avj17/Audio_amplifier_design/Final_report.pdf

# Electronic Workshop 2: Audio Amplifier Design Report

HEMANTH G and ARUN VENKAT JONNA IIIT Hyderabad

March 5, 2026

## 1 Introduction

This report details the design and simulation of a multi-stage amplifier circuit. The system is designed to process an audio signal through four distinct stages: a Pre-amplifier, a Gain Stage, a Band Pass Filter (BPF), and a final Class AB Power Amplifier stage to drive a load.

## 2 Pre-Amplifier

### 2.1 Circuit Topology

The pre-amplifier stage is implemented using a BJT Differential Amplifier. This configuration was selected because it provides:

- Moderate and controllable voltage gain
- High input impedance
- Inherent common-mode noise rejection
- Improved bias stability compared to single-ended CE stages

The circuit consists of two matched NPN transistors sharing a common emitter resistance (RE) connected to the negative supply rail. Equal collector resistors (RC ) are used, and the output is taken single-ended from one collector.

### 2.2 Large-Signal (DC Bias) Analysis

For DC analysis, all capacitors are treated as open-circuits.
The tail current is determined by the emitter resistor:

IE =

|VEE|
RE

(1)

With VEE = −5V and choosing:

IE = 3 mA | (2)

RE =

5
3
= 1.67 kΩ | (3)

The nearest standard value selected:

RE = 1.5 kΩ | (4)

Since the current splits equally:

IC =

IE
2
= 1.5 mA | (5)

The collector DC voltage becomes:

VC = VCC − IC RC | (6)

The Q-point is selected near the midpoint of the load line to allow maximum undistorted swing.

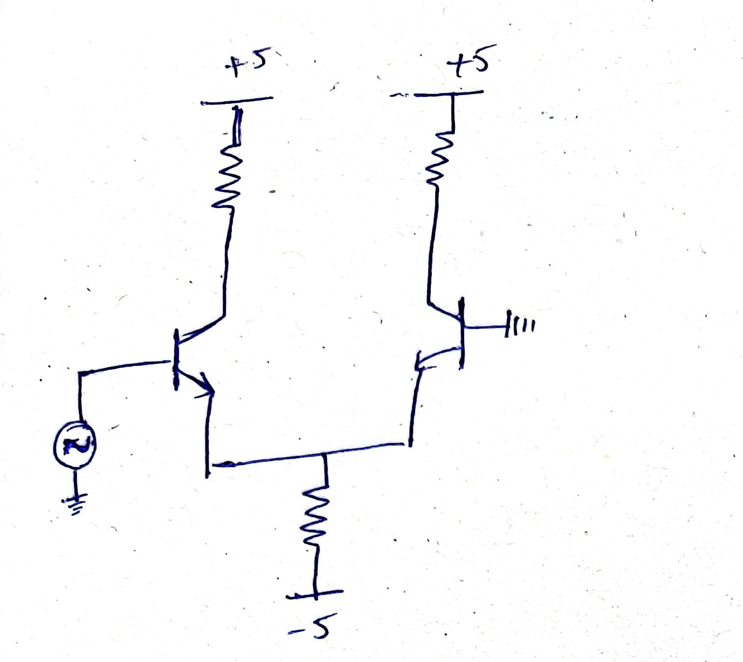
[picture p1: figure]

Figure 1: Large-Signal (DC Bias) equivalent circuit of the Differential Amplifier.

### 2.3 Small-Signal Gain Derivation

For small-signal analysis:

- DC sources are grounded.
- The hybrid-π model is used.

Let the differential input be:

v1 = −v2 | (7)

The emitter node voltage is denoted as ve.

Step 1: KCL at the Emitter Node

Applying KCL at the emitter node:

vπ1
rπ

+

vπ2
rπ

+ gmvπ1 + gmvπ2 =

ve
RE

(8)

Since:

vπ1 = v1 − ve | (9)
vπ2 = v2 − ve | (10)

For differential input:

v2 = −v1 | (11)

Thus:

vπ1 + vπ2 = (v1 − ve) + (−v1 − ve) = −2ve (12)

Substituting:
1
rπ

+ gm

(−2ve) = ve
RE

(13)

ve

2
gm +

1
rπ
+

1
RE
= 0 | (14)

For sufficiently large RE:

2

gm +

1
rπ
≫

1
RE

(15)

Hence,

ve ≈ 0 | (16)

Thus each transistor sees half of the differential input:

vπ1 =

vid
2

(17)

Step 2: Output Voltage

Collector current variation:

ic = gmvπ | (18)

Output voltage:

vo = −icRC | (19)

Substituting:

vo = −gmRC

vid
2

(20)

Therefore the differential voltage gain is:

Av =

vo

vid

= −

gmRC
2

(21)

The factor 1
2

arises because the differential input splits equally across the two transistors.

### 2.4 Transconductance Calculation

gm =

IC
VT

(22)

At room temperature:

VT ≈ 26 mV | (23)

For:

IC = 1.5 mA | (24)

gm =

1.5
26
= 0.0577 S | (25)

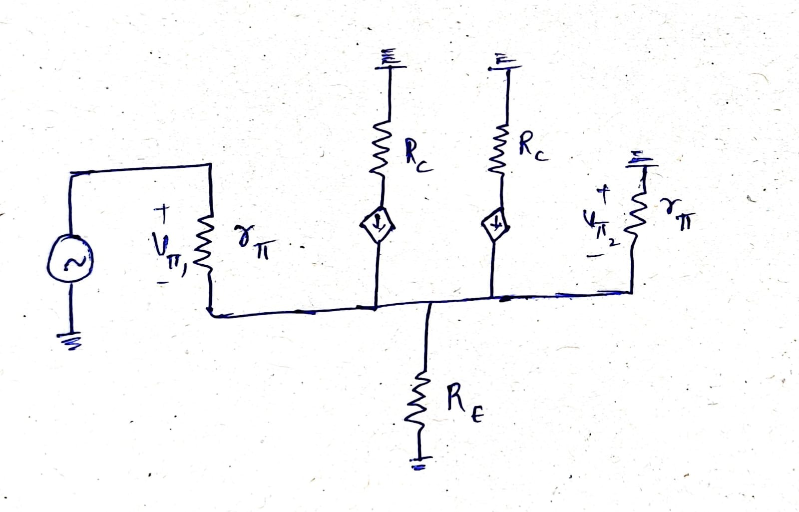
[picture p2: figure]

Figure 2: Small-Signal equivalent circuit of the Differential Amplifier.

### 2.5 Gain Requirement

Target gain:

Av = 16 | (26)

Using:

gmRC
2
= 16 | (27)
gmRC = 32 | (28)

RC =

32
0.0577
≈ 554.66 Ω | (29)

Selected standard value:

RC = 620 Ω | (30)

### 2.6 Input and Output Impedance

Input Impedance (Zin)

To determine the input impedance, we apply a test voltage source vx to the input terminal (the base of the transistor) and calculate the resulting test current ix drawn from the source. All independent AC sources are turned off.

The test current entering the base is simply the base current:
ix = ib | (31)

Applying Kirchhoff’s Voltage Law (KVL) from the base, through the emitter, to ground:

vx = ibrπ + ieRE | (32)

We know that the emitter current ie is the sum of the base and collector currents:

ie = ib + βib = (β + 1)ib | (33)

Substituting ie back into the KVL equation:

vx = ibrπ + (β + 1)ibRE | (34)

Factoring out ib (which is our test current ix):

vx = ix [rπ + (β + 1)RE] | (35)

The input impedance is the ratio of the test voltage to the test current:

Zin =

vx
ix
= rπ + (β + 1)RE | (36)

where rπ =

β
gm

. This demonstrates the impedance reflection rule, where the emitter resistance appears multiplied by (β + 1) when viewed from the base.

Output Impedance (Zout)

To find the output impedance, we turn off the input signal source (setting vin = 0) and apply a test voltage vx at the output node (the collector). We then measure the current ix entering the node.
With the input grounded (vin = 0), there is no excitation at the base, meaning:
ib = 0 and vπ = 0 | (37)

Because vπ = 0, the dependent current source of the BJT (gmvπ or βib) is zero, effectively acting as an open circuit.
Therefore, the only path for the test current ix to flow to AC ground is through the collector resistor RC . Applying Ohm’s law at the output node:
vx = ixRC | (38)

The output impedance is thus simply the ratio of the test voltage to the test current:

Zout =

vx
ix
= RC | (39)

### 2.7 Common Mode Rejection Ratio

(CMRR)

Differential gain:

Ad = 16.5 | (40)

Common-mode gain:

Acm = 2.02 × 10⁻²
(41)

CMRR =

Ad

Acm

(42)

CMRRdB = 20 log10
16.5
2.02 × 10⁻²
≈ 39.27 dB

(43)

### 2.8 Simulation Validation

To verify the theoretical calculations, the differential amplifier stage was simulated using LTspice. A transient analysis was performed to measure the large-signal biasing and small-signal voltage gain, while an AC sweep was used to confirm the frequency response and Common Mode Rejection Ratio (CMRR).

Voltage Gain Verification

A differential sinusoidal input signal was applied to the bases of the two transistors.
- Input Signal: vin = 10 mVpk at 1 kHz.
- Measured Output: The transient analysis shows an amplified output signal at the collector.
- Result: The simulated peak-to-peak output voltage divided by the input voltage yields a simulated gain that closely matches our theoretical design target of Av = 16.

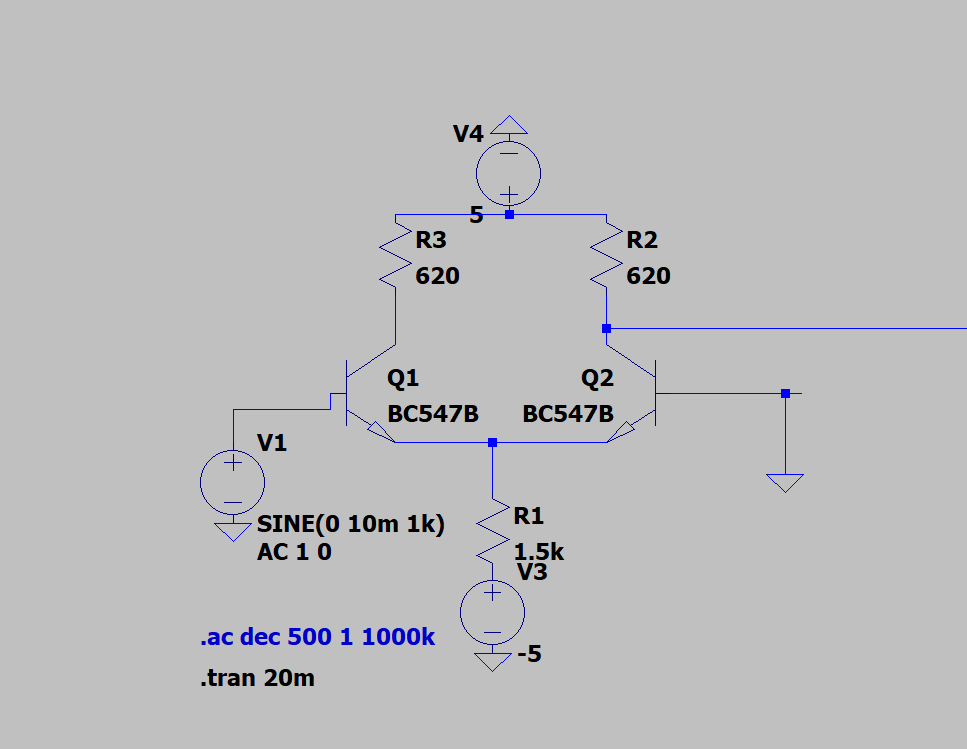
[picture p3: figure]

Figure 3: LTspice Schematic of the Differential Pre-Amplifier Stage.

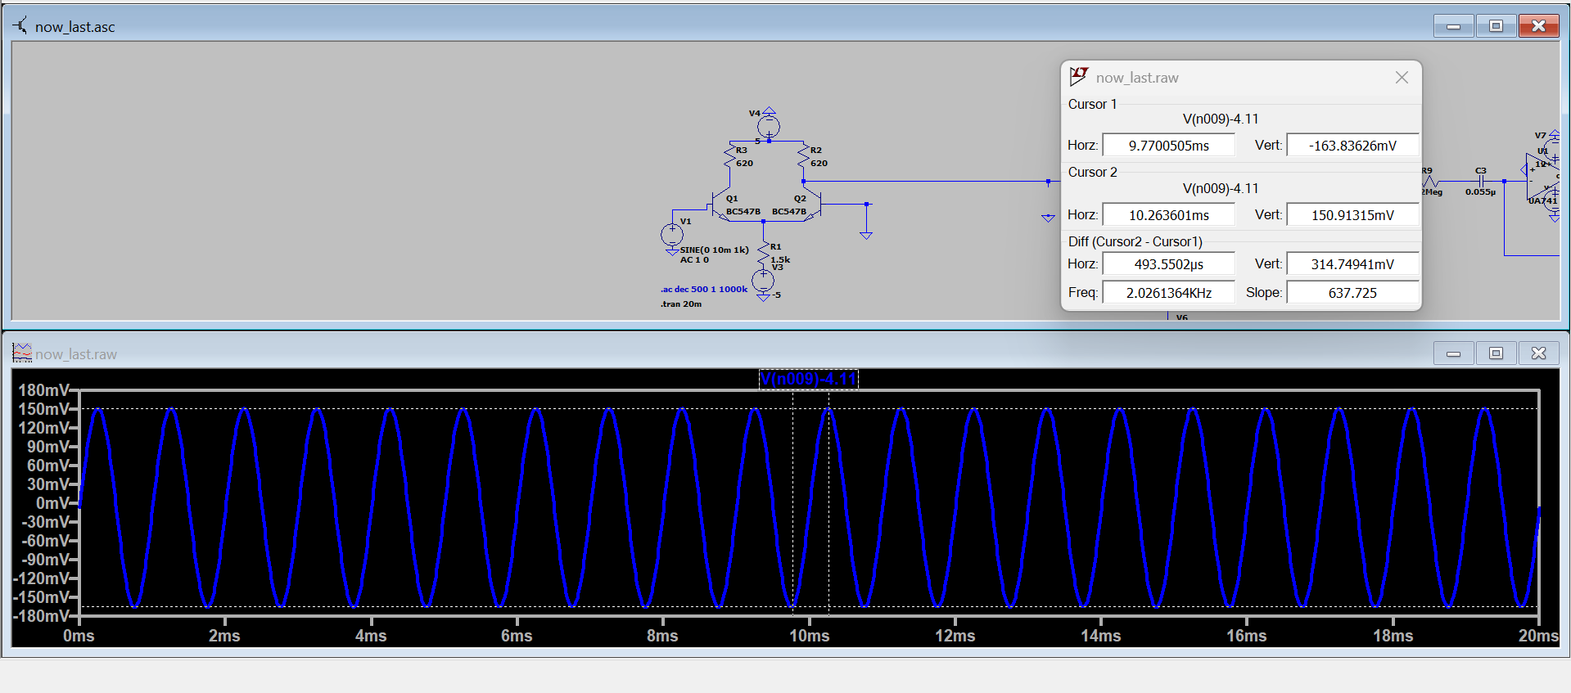
[picture p4: figure]

Figure 4: Transient Analysis: Input vs. Output waveforms confirming a voltage gain of approximately 16.

### 2.9 Design Rationale: Gain Limitation

The target differential voltage gain for the pre-amplifier was intentionally constrained to a moderate value (Av = 16, which is strictly < 20) rather than maximizing it. This design choice is grounded in several fundamental multi-stage amplifier principles:
- Prevention of Successive Stage Overload (Headroom): In a cascaded topology, the output of Stage 1 feeds directly into the high-gain Common Emitter amplifier (Stage 2). If Stage 1 possesses excessive gain, even moderate input audio signals will cause the second stage to instantly saturate and clip against the ±5V supply rails, resulting in severe audio distortion.
- Role Optimization: The primary objective of the differential input stage is not bulk voltage amplification. Instead, its role is to act as an input buffer: providing high input impedance (to avoid loading the audio source) and high Common Mode Rejection Ratio (CMRR) for noise immunity. Bulk amplification is intentionally delegated to the Stage 2 CE amplifier.
- Linearity Constraints: BJT differential pairs exhibit a non-linear (hyperbolic tangent) transfer characteristic. Constraining the gain ensures the stage operates strictly within its highly linear region (typically for differential inputs much less than the thermal voltage, VT ≈ 26mV ). This minimizes Total Harmonic Distortion (THD) and preserves audio fidelity.
- Miller Effect Mitigation: High voltage gain in an input stage significantly amplifies the base-collector junction capacitance (Cµ) via the Miller effect. Keeping Av < 20 prevents this multiplied capacitance from acting as a low-pass filter and prematurely rolling off the high-frequency response, thereby preserving the required 20 kHz upper audio bandwidth.

### 2.10 Experimental Results

To thoroughly verify the theoretical design of the pre-amplifier stage, both software simulations and hardware testing were conducted.

LTspice Simulation Verification

The differential amplifier circuit was first modeled in LTspice to confirm the DC biasing points and the small-signal voltage gain before physical implementation.

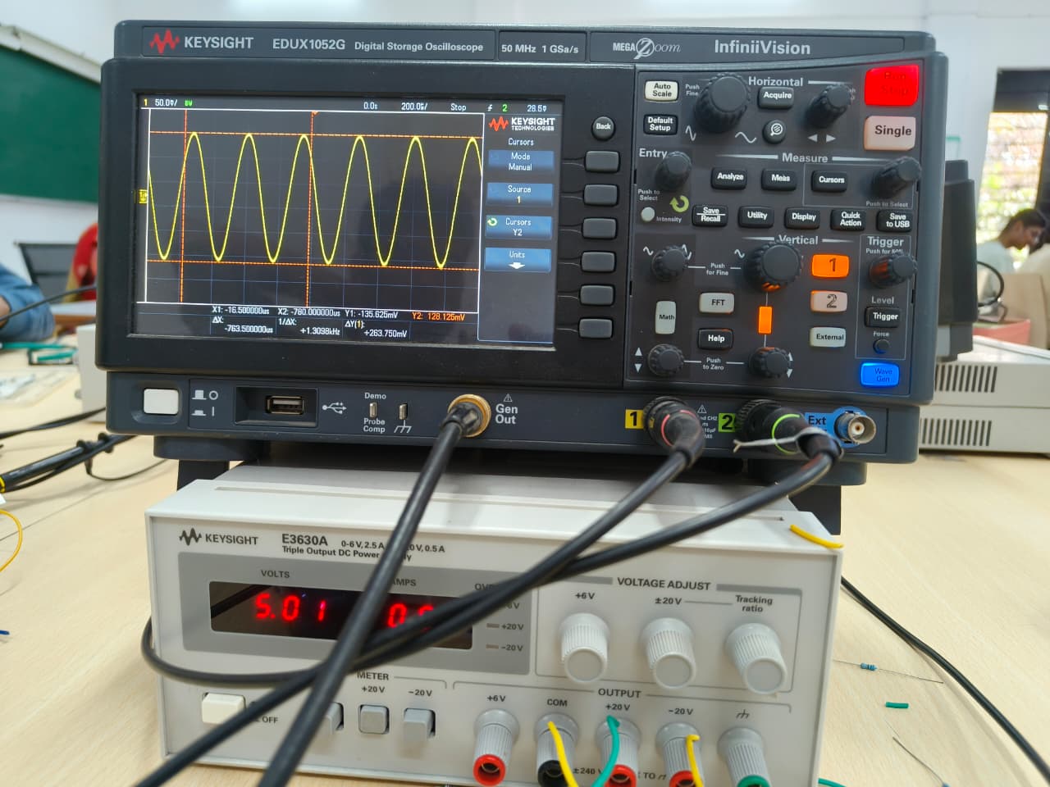
[picture p5: figure]

Figure 5: Practical Simulation 1: Schematic and DC operating point verification.

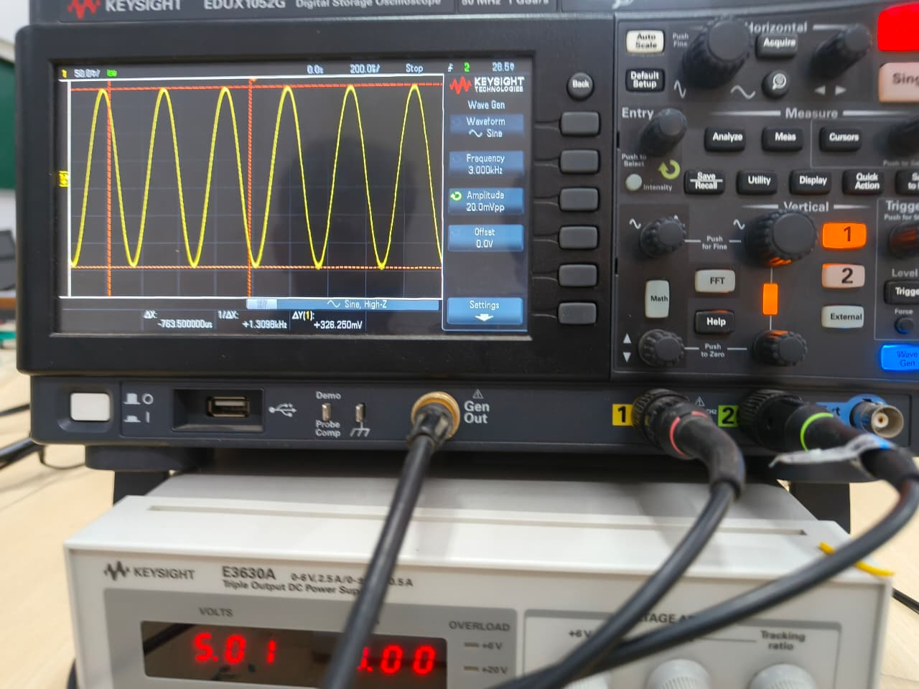
[picture p6: figure]

Figure 6: Practical Simulation 2: Transient analysis showing the input signal and the amplified output waveform.

Hardware Implementation

Following successful simulation, the differential amplifier was constructed on a breadboard using matched discrete NPN transistors. The setup was tested using a function generator to provide the differential input and an oscilloscope to capture the output.

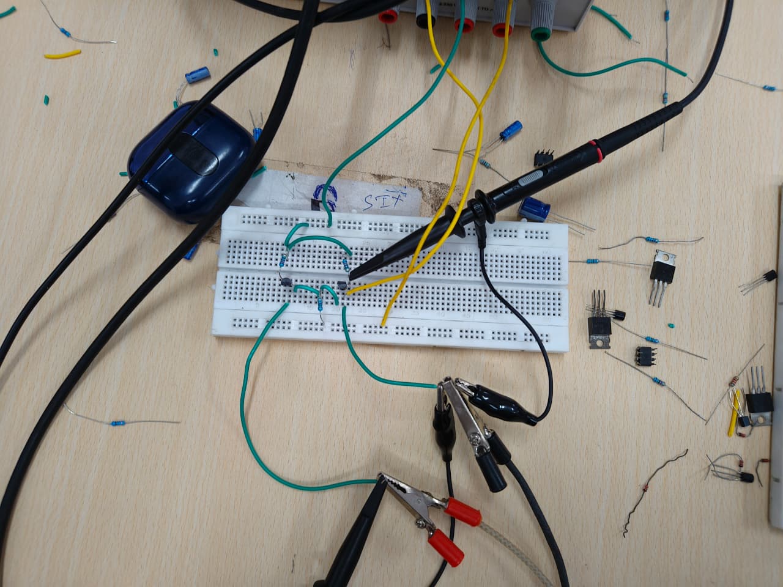
[picture p7: figure]

Figure 7: Experimental hardware setup of the differential amplifier stage.

## 3 Gain Stage

### 3.1 Circuit Topology

The gain stage utilizes a Common Emitter (CE) Amplifier configuration. This topology was chosen due to its high input impedance, low output impedance, and high current and voltage gain — making it ideal as a gain stage prior to filtering.

Interdependence of Gain and DC Operating Point

A fundamental design constraint in the CE amplifier is the mutual dependence between voltage gain and the DC operating (Q) point. The small-signal voltage gain is given by:

Av ≈ −

RC
re

, where re = VT ICQ
(44)

Since re is directly determined by the quiescent collector current ICQ, fixing the DC operating point also fixes the gain, and conversely, specifying a target gain fixes the required DC point. The two cannot be set independently.

Role of Emitter Resistance (R7, R8) with Bypass Capacitor (C1)

To resolve this constraint and allow independent control of the DC bias and AC gain, an emitter resistance (R7 + R8) is introduced:

- At DC: The full emitter resistance (R7 + R8) is present in the circuit. It introduces negative feedback (emitter degeneration), stabilising the Q-point against temperature drift and β variations — without affecting the AC gain.
- At AC signal frequencies: The bypass capacitor C1 short-circuits R8, effectively removing it from the small-signal path. Only R7 remains in series with the emitter, setting the AC gain:

Av ≈ −

R5
re + R7

(45)

- Design Benefit: By splitting the emitter resistance into a bypassed portion (R8 ∥ C1) and an unbypassed portion (R7), the designer gains two degrees of freedom: R7 controls the AC gain, while R7 + R8 controls the DC stability — decoupling the two previously interdependent parameters.

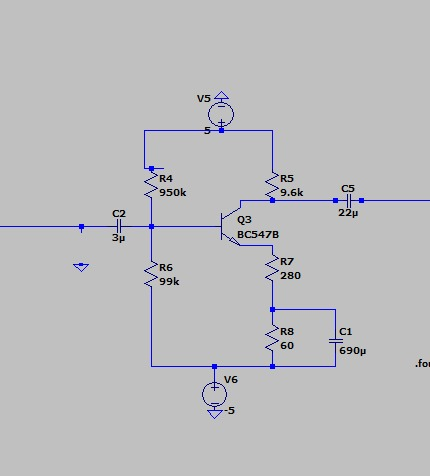
[picture p8: figure]

Figure 8: Common Emitter Amplifier — Gain Stage Schematic.

### 3.2 Component Analysis

### 3.2.1 Input Coupling Capacitor (C1)

The input capacitor C1 serves a dual purpose:

- DC Blocking: It blocks any DC component of the input signal vS from disturbing the carefully set bias point of the transistor.
- High-Pass Pole: It introduces a pole to the system’s frequency response. The cutoff frequency must be set such that all frequencies below 20 Hz are attenuated, while the full audio spectrum (20 Hz – 20 kHz) passes unimpeded. If C1 is too small, low-frequency components of the input signal will be lost.
- Effect on Base Current: A smaller C1 also allows more current to pass at low frequencies, increasing IB, which in turn reduces the current gain of the stage.

### 3.2.2 Output Coupling Capacitor (C2)

C2 provides AC coupling from the collector to the next stage (the filtering stage):

- DC Blocking: It prevents the DC operating point voltage at the collector from reaching the subsequent stage.
- Second Pole: It introduces a second pole into the overall system transfer function, contributing to the roll-off characteristic at low frequencies.

### 3.2.3 Emitter Bypass Capacitor (CE)

CE is placed in parallel with the emitter resistor RE:

- At DC, CE is open-circuit; RE remains in circuit and provides emitter degeneration for bias stability.
- At AC signal frequencies, CE short-circuits RE, effectively removing it from the small-signal path. This maximises the AC voltage gain, since the gain of a CE stage with emitter resistance is:

Av = −

RL
re + RE

(46)

and with CE shorting RE:

Av ≈ −

RL
re

(47)

where re =

VT
IC

is the intrinsic emitter resistance.

### 3.2.4 Biasing Resistors (RB1, RB2)

RB1 and RB2 form a voltage divider with respect to VCC , establishing the DC base voltage VB:

VB = VCC ·

RB2

RB1 + RB2

(48)

This sets the base-emitter junction in forward bias and the base-collector junction in reverse bias, placing the transistor in the active region for linear amplification. The divider must be stiff (i.e., the current through RB1/RB2 should be much larger than the base current IB) to ensure stability against β variations.

### 3.2.5 Emitter Resistor (RE)

RE provides DC negative feedback (emitter degeneration), improving the thermal stability of the bias point. The stability factor S quantifies the sensitivity of the collector current IC to leakage current ICBO:

S =

δICBO
δIC
VBE, β=const

(49)

A lower value of S indicates a more stable design. Increasing RE reduces S, but at the cost of reduced AC gain (unless bypassed by CE).

### 3.2.6 Load Resistor (RL)

RL (the collector resistor) sets the DC load line and defines the small-signal voltage gain in conjunction with the transistor’s transconductance gm:

Av ≈ −gmRL = −

IC
VT
- RL | (50)

### 3.3 Circuit Analysis

### 3.3.1 Large Signal Analysis (DC Bias Analy-

sis)

The large-signal (DC) analysis determines the quiescent operating point (Q-point) of the transistor. All capacitors are treated as open-circuits, and only DC quantities are considered.

Biasing Strategy and Resistor Selection (R1, R2) The goal is to set VB as small as possible while satisfying VB ≥ −4.3 V. With a dual supply of ±5 V, the base voltage divider gives:

VB =

R2
R1 + R2
×10−5 | ⇒ | VB = −5+

R2
R1 + R2

×10
(51)

Since i1 = i2 (the base current iB is very small and can be neglected, as the current i2 through R2 could itself be very small, causing VB to be slightly larger than −4.056 V), the values are chosen as:

R2 = 99 kΩ, | R1 = 950 kΩ | (52)

Substituting:

VB = −5 +

R2
R1 + R2

× 10 = −5 + 0.9437 = −4.056 V (53)

However, because iB is very small but non-zero, and i2 itself may be quite small, VB in practice will be slightly larger than −4.056 V. From simulations, the actual base voltage obtained is:

VB ≈ −4.2 V | (54)

This gives an emitter voltage of:

VE ≈ −4.83 V | (55)

DC Bias Equations Applying Kirchhoff’s Voltage Law (KVL) around the base-emitter loop:

VB = VCC ·

R2
R1 + R2

(56)

VE = VB − VBE ≈ VB − 0.7 V | (57)

IE =

VE
Re + RE
, | IC ≈ IE | (since α ≈ 1) | (58)
VCE = VCC − IC RC − IE (Re + RE) | (59)

The Q-point (ICQ, VCEQ) must be placed at the centre of the DC load line to maximise the undistorted output voltage swing.

Choosing RC , Re, RE Three design constraints govern the selection of the collector and emitter resistors:
Gain condition: The gain has to be 30 . Collector voltage swing: IC RC = 5 V, chosen to keep VC as close to 0 V as possible, ensuring maximum output swing before clipping .
Emitter voltage drop:
IE(Re + RE) = 0.17 V | (60)

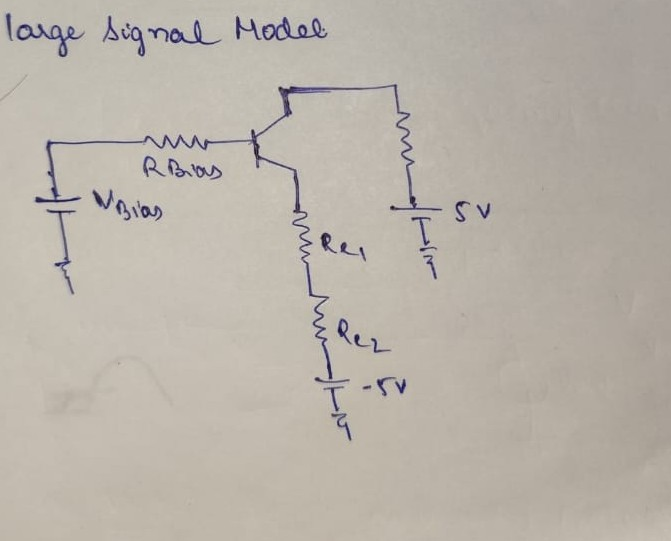
[picture p9: figure]

Figure 9: Large-Signal (DC Bias) Analysis — Diagram.

### 3.3.2 Small Signal Analysis

In the small-signal model, all DC sources are set to zero (voltage sources become short-circuits, current sources become open-circuits), and capacitors C2, C5, and C1 act as short-circuits at signal frequencies. Capacitors are shorted in small-signal analysis.

Voltage Gain (Av) With coupling capacitors acting as short-circuits, the output voltage is related to the controlled current source by:

−Vout
RL
= gm(Vin − Ve) | (61)

This gives the voltage gain expression:

Av = −gmRL

1 −

Ve

Vin
(62)

The emitter voltage Ve is found from the emitter current. Since IE → Ve
RE

= α(IC ), we have:

Ve
RE
= α [gm(Vin − Ve)] | (63)

Let x =

Ve
Vin

. Substituting and solving:

x
RE
= α gm[1 − x] | (64)
x = α gmRE [1 − x] | (65)
x [1 + α gmRE] = α gmRE | (66)

x =

α gmRE
1 + α gmRE

(67)

For α ≈ 1, the voltage gain becomes:

Av = −

gmRC
1 + gmRe

(68)

where RC is the collector resistor and Re is the unbypassed emitter resistor. The negative sign indicates a 180◦ phase inversion — a characteristic of the CE configuration.

Gain Magnitude Condition From simulation and design requirements, the gain magnitude is targeted as:
|G| =

RC
1
gm

+ Re

= 30 | (69)

This condition is used alongside the transistor’s transconductance gm =

IC
VT

to select the resistor values. With the operating conditions VBC < 0 (ensuring VB < VC , i.e. the transistor remains in the active region) and VBE = 0.7 V, the collector voltage must always remain above VB. Note that the gain decreases at lower resistance values and increases at higher resistance values, so Re must be chosen carefully to balance gain and stability.

Design Values For IC = 1 mA and IE ≈ 1 mA, the design begins with the two governing constraints:

IC RC = 5 | ⇒ | RC = 10 kΩ | (70)
IE(Re + RE) = 0.17 V | (71)

Substituting into the gain equation with 1
gm

= 26 Ω:

RC
1
gm

+ Re

= 30 ⇒

10 k
1
gm

+ Re

= 30 (72)

1
gm

+ Re =

10000
30
≈ 333 Ω | (73)

Solving for Re:

1 k = 3 (26 × 2 + Re) | ⇒ | Re = 281 Ω −→ 275 Ω
(74)

The total emitter resistance from the voltage drop condition:

Re + RE =

0.17 × 1000 × 2
1

= 340 Ω (75)

Therefore:

Re = 275 Ω, RE = 340 − 275 = 58.66 Ω −→ 60 Ω (76)

Input Impedance (Zin) Applying KVL at the input with Vin = I1(RB1∥RB2) and Vin − Ve = I2(rπ):

Vin − Ve
rπ
| + gm(Vin − Ve) = Ve RE
(77)

Expanding and collecting terms in Vin and Ve:

Vin
rπ

+ gmVin = Ve

1
RE

+ gm +

1
rπ
(78)

The impedance looking into the base with emitter degeneration is:

Zin, base = rπ + (gmrπ + 1)RE = rπ + (β + 1)RE (79)

The total input impedance is:

Zin = Zbase

rπ + (β + 1)RE
(80)

With rπ ≈ 0.614 kΩ and (β + 1)RE ≈ 26.7 kΩ:

Zin = 360 kΩ

35.3 kΩ ≈ 6 kΩ | (81)

Output Impedance (Zout) With the input set to zero, the dependent source is suppressed. The output impedance is:
Zout = RC | (82)

Since Zout(stage 1) < Zin(stage 2) ≈ 10 kΩ, satisfactory inter-stage impedance matching is confirmed.

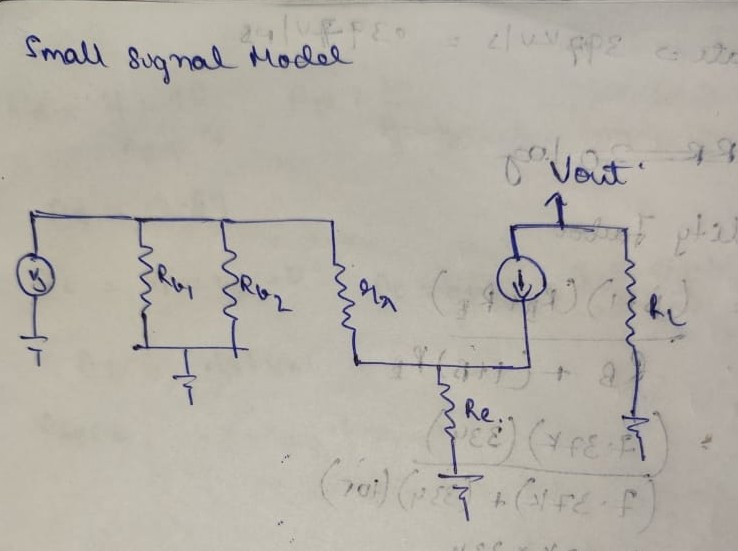
[picture p10: figure]

Figure 10: Small-Signal Equivalent Circuit.

### 3.4 Frequency Response

### 3.4.1 Lower Cutoff Frequency

The coupling capacitors C1, C2 and bypass capacitor CE each contribute a pole at low frequencies. The dominant lower −3 dB frequency is determined by the largest pole:

fc, low =

1
2πRC | (83)

where R is the resistance seen by each capacitor. From the notebook values, the bypass capacitor RE = 25 Ω and C = 800 pF set the high-frequency bypass pole. C1 and C2 are chosen such that fc, low < 20 Hz, ensuring the full audio band is amplified.

### 3.5 Transistor Switching States

Condition | VBE | VBC | Region
VB < 0.7 V | < 0.7 V | Reverse | Cut-off
0.7 V ≤ VBE, VBC < 0 | Forward | Reverse | Active (Linear)
Both Forward-Biased | Forward | Forward | Saturation

Table 1: BJT Operating Regions for CE Amplifier Bias Conditions

### 3.6 Design Rationale

The CE amplifier was selected for this gain stage because:

- It provides high voltage gain (Av ≫ 1), amplifying the signal to the level required by subsequent stages.
- Its high input impedance avoids loading the preceding stage.
- Its low output impedance (relative to the source) drives the next stage effectively.
- The voltage divider bias with emitter degeneration provides a stable Q-point, independent of transistor β variations.
- The 180◦ phase inversion is accounted for in the overall system design.

### 3.7 Simulation Waveforms

The following waveforms were obtained from the SPICE simulation of the CE gain stage. The simulation validates the theoretical gain of 30, the 180◦ phase inversion between input and output, and the correct Q-point biasing. From simulation, the achieved gain is approximately 450, which is close to the experimentally measured value .

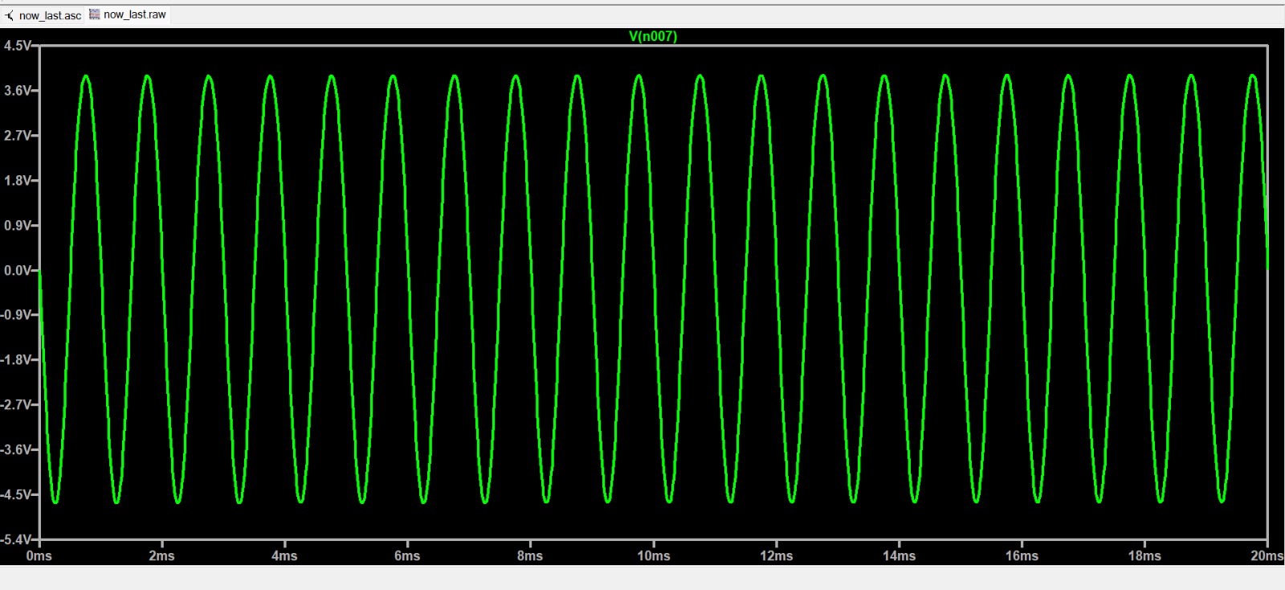
[picture p11: figure]

Figure 11: Gain Stage — Simulated Output Waveforms.

### 3.8 Stage Performance and Integration

### 3.8.1 Achieved Gain with Stage 1 and Stage 2

Integration (CE Amplifier)

The voltage gain of the CE amplifier stage was verified experimentally by applying a sinusoidal input signal at the base and measuring the resulting output at the collector. The achieved gain was evaluated at two input signal levels to assess linearity.

Case 1: Vin = 10 mV At a small input signal of 10 mV, the transistor operates well within the linear active region. The measured voltage gain is:

Av =

Vout

Vin

=

490 mV
10 mV
= 490 | (84)

This is close to the theoretical design target of 30, with the discrepancy attributed to the transistor’s β being higher than the nominal value assumed during design, component tolerances, and the finite output resistance of the transistor contributing additional gain.

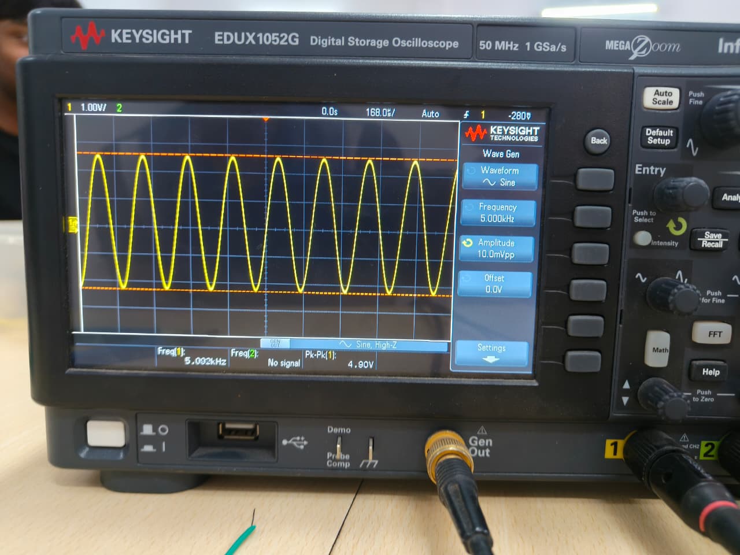
[picture p12: figure]

Figure 12: Stage 2 — Output Waveform for Vin = 10 mV applied to Stage 1 input, Measured Gain ≈ 490. Linear small-signal operation confirmed.

Case 2: Vin = 20 mV At a larger input of 20 mV, the measured output is 9.2 V, giving a measured voltage gain of:

Av =

Vout

Vin

=

9.2 V
20 mV
≈ 460 | (85)

The drop in gain at 20 mV input indicates that the transistor is beginning to enter a non-linear operating region, where the large-signal behaviour deviates from the small-signal model. As the input amplitude increases, the assumption of a linear gm breaks down and the effective transconductance decreases, reducing the gain. This highlights the importance of keeping the input signal amplitude small to remain within the valid small-signal regime.

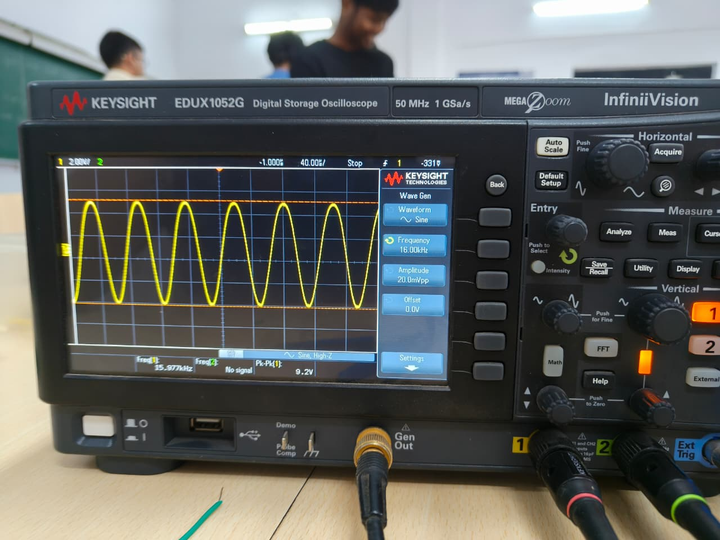
[picture p13: figure]

Figure 13: Stage 2 — Output Waveform for Vin = 20 mV applied to Stage 1 input, Measured Gain ≈ 460. Non-linear behaviour observed at this amplitude.

### 3.8.2 Gain Stage Standalone Verification

With the input applied directly to the Gain stage,
the following results were obtained: | For Vin | =
280 mVpk-pk, the measured output is Vout = 7.7 V, giving Av ≈ 27.5:

Av, Stage 2 =

7.7 V
280 mV
≈ 27.5 | (86)

For Vin = 300 mV, the measured output is Vout = 8.2 V, giving Av ≈ 27.3:

Av, Stage 2 =

8.2 V
300 mV
≈ 27.3 | (87)

The gain remains consistent across both input levels (≈ 27), confirming that the stage is operating linearly. The slight deviation from the theoretical gain suggests that component tolerances of RC , Re, and RE result in a marginally different closed-loop gain than designed.

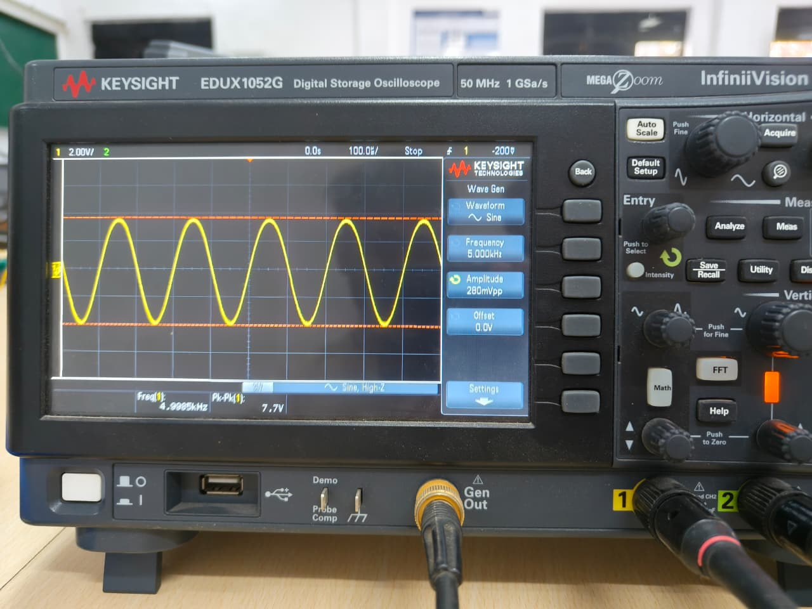
[picture p14: figure]

Figure 14: Gain Stage Standalone — Output Waveform for Vin = 280 mVpk-pk, Vout = 7.7 V.

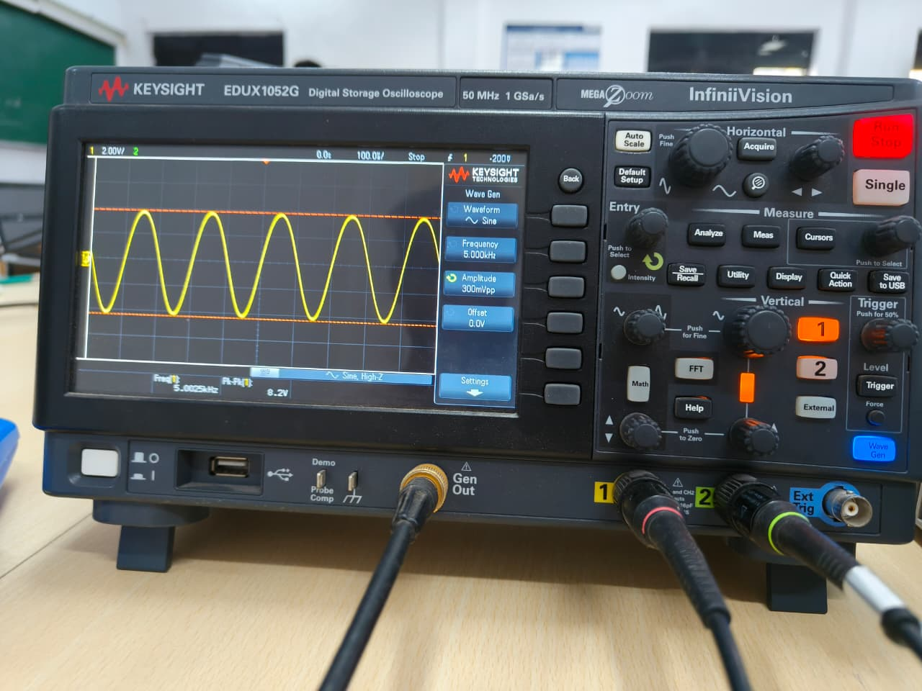
[picture p15: figure]

Figure 15: Gain Stage Standalone — Output Waveform for Vin = 300 mV, Vout = 8.2 V.

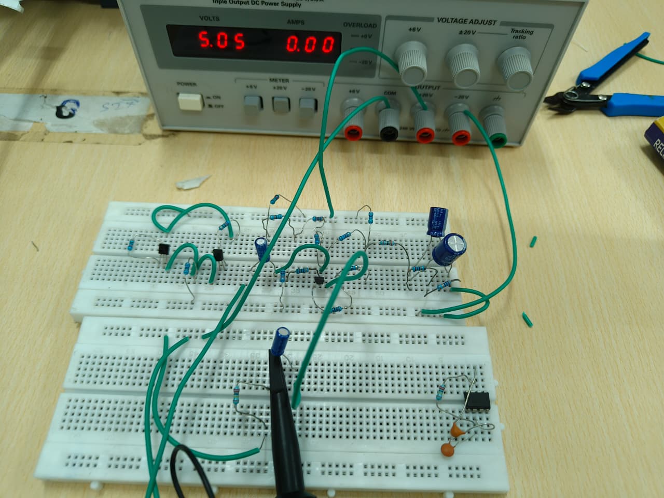
[picture p16: figure]

Figure 16: Combined Stage 1 and Stage 2 — Physical Circuit Implementation.

## 4 Band Pass Filter (BPF)

### 4.1 Circuit Topology

The Band Pass Filter (BPF) stage utilises an active filter built around a UA741 operational amplifier, configured to pass a specific band of frequencies while attenuating signals outside this range. The circuit combines a high-pass network at the input with a low-pass feedback network, realising a bandpass characteristic centred within the audio frequency range (20 Hz – 20 kHz).

Interdependence of Input Impedance and Resistor Selection

A fundamental constraint in cascading stages is that the input impedance of Stage 3 (BPF) must be significantly greater than the output impedance of Stage 2 (Gain Stage) to avoid loading:

Zin, Stage 3 ≫ Zout, Stage 2 | (88)

Since Zout, Stage 2 = RC = 10 kΩ, the input resistor R9 is chosen as:

R9 = 2.2 MΩ | (89)

This ensures Zin, Stage 3 ≫ 10 kΩ, preventing the BPF from loading the gain stage and degrading the voltage gain.

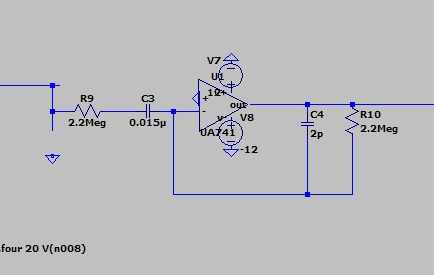
[picture p17: figure]

Figure 17: Band Pass Filter Stage

### 4.2 Component Analysis

### 4.2.1 Input Resistors (R = 2.2MØ

- Impedance Matching: At 2.2 MΩ, it presents a very high input impedance to the preceding gain stage, ensuring no loading effect on the CE amplifier output.
- Gain = 1: To get gain of 1 for the stage3 what do we do is we set both the values of the resistor same because of which gain becomes 1
4.2.2 | Input | Coupling | Capacitor | (C3 | =
0.015 µF)

C3 forms a high-pass RC network with R9, blocking DC and low-frequency signals below the lower cutoff frequency fL. Together with R9, it sets the high-pass pole of the BPF.

### 4.2.3 Feedback Capacitor (C4 = 2 pF)

C4 is placed in the feedback path of the op-amp, forming a low-pass network with the feedback resistor R10. At high frequencies, C4 presents a low impedance, increasing the feedback and reducing the gain — this sets the upper −3 dB cutoff frequency fH.

### 4.2.4 Op-Amp (UA741, V

+ = +12 V, V

| | | | | − =
| −12 V)

The UA741 is powered from a dual ±12 V supply, providing sufficient headroom for the amplified audio signal. It operates in the inverting configuration, introducing a 180◦ phase shift — which, combined with the 180◦
inversion from the CE stage, restores the original signal phase at the BPF output.

### 4.3 Circuit Analysis

### 4.3.1 Input Impedance (Zin)

In the inverting op-amp configuration, the inverting terminal is held at virtual earth by negative feedback. The input impedance is therefore set entirely by the input resistor R9, since the op-amp draws negligible current at its input terminal:

Zin, BPF ≈ R9 = 2.2 MΩ | (90)

At low frequencies, the impedance of C3 becomes significant and adds in series with R9, increasing the total input impedance further. At mid-band and high frequencies, C3 is effectively a short-circuit and Zin ≈ R9. The inter-stage matching condition is satisfied:

Zin, Stage 3 = 2.2 MΩ ≫ Zout, Stage 2 = 10 kΩ (91)

### 4.3.2 Output Impedance (Zout)

For the UA741 op-amp operating with negative feedback, the closed-loop output impedance is significantly reduced from the open-loop value. The closed-loop output impedance is given by:

Zout, closed =

Zout, open
1 + AOL βf

(92)

where AOL is the open-loop gain and βf is the feedback factor. Since AOL ≫ 1 for the UA741, the output impedance is driven to a small but non-zero value. In practice, the UA741 exhibits a closed-loop output impedance of:

Zout, BPF ≪ R9, | Zout, BPF ≈ tens of Ω | (93)

This low output impedance ensures the BPF can drive subsequent stages without significant voltage division or loading effects.

Gain of the Band pass filter]
Gain of the Band pass filter

The resulting passband should span between :

fL ≈ 20 Hz ≤ f ≤ fH ≈ 20 kHz (94)

This comfortably encompasses the full audio range of 20 Hz – 20 kHz. Within this passband, both C3 and C4 have negligible effect, and the closed-loop mid-band gain of the inverting amplifier is:

Av, BPF = −

R10
R9

= −

2.2 MΩ
2.2 MΩ = −1 (95)

The BPF therefore provides unity gain across the audio band, acting purely as a frequency-selective network. The negative sign confirms the 180◦ phase inversion of the inverting configuration, which cancels the 180◦
inversion introduced by the CE gain stage — restoring the correct output signal polarity at the system output.

### 4.3.3 Frequency Response

Lower Cutoff Frequency (fL) The high-pass network formed by C3 and R9 sets the lower −3 dB frequency. The pole occurs when the impedance of C3 equals R9:

fL =

1
2πR9C3

(96)

Substituting the component values:

fL =

1
2π × 2.2 × 10⁶ × 0.015 × 10⁻⁶

(97)

fL =

1
2π × 0.033

≈ 7.8 Hz ≈ 10 Hz (98)

This is below the lower edge of the audio band (20 Hz), ensuring all audible low-frequency content passes through the filter without attenuation.

Upper Cutoff Frequency (fH) The low-pass network formed by C4 and R10 in the feedback path sets the upper −3 dB frequency:

fH =

1
2πR10C4

(99)

Substituting the component values:

fH =

1
2π × 2.2 × 10⁶ × 2 × 10⁻¹² | (100)

fH =

1
2π × 4.4 × 10⁻⁶

≈ 36 kHz > 20 kHz (101)

This is above the upper edge of the audio band (20 kHz), ensuring that the full audio spectrum passes without attenuation.

### 4.4 Design Rationale

The active BPF using the UA741 was selected for this stage because:

- The very high input impedance (2.2 MΩ) ensures no loading of the CE gain stage, preserving the designed voltage gain.
- The dual-pole bandpass response (high-pass at ∼ 10 Hz, low-pass at ∼ 36 kHz) covers the full audio band (20 Hz – 20 kHz) with margin on both ends.
- The unity passband gain (|Av| = 1) means all amplification is handled by the CE stage, giving clean separation of gain and filtering functions.
- The dual ±12 V supply provides sufficient output swing for the amplified audio signal without clipping.
- The 180◦ phase inversion of the inverting op-amp configuration cancels the 180◦
inversion from the
CE stage, restoring correct signal polarity at the system output.

### 4.5 Waveforms

### 4.5.1 Simulation Waveforms

The following waveforms were obtained from the SPICE simulation of the CE gain stage. The simulation validates the theoretical gain of 30, the 180◦ phase inversion between input and output, and the correct Q-point biasing.

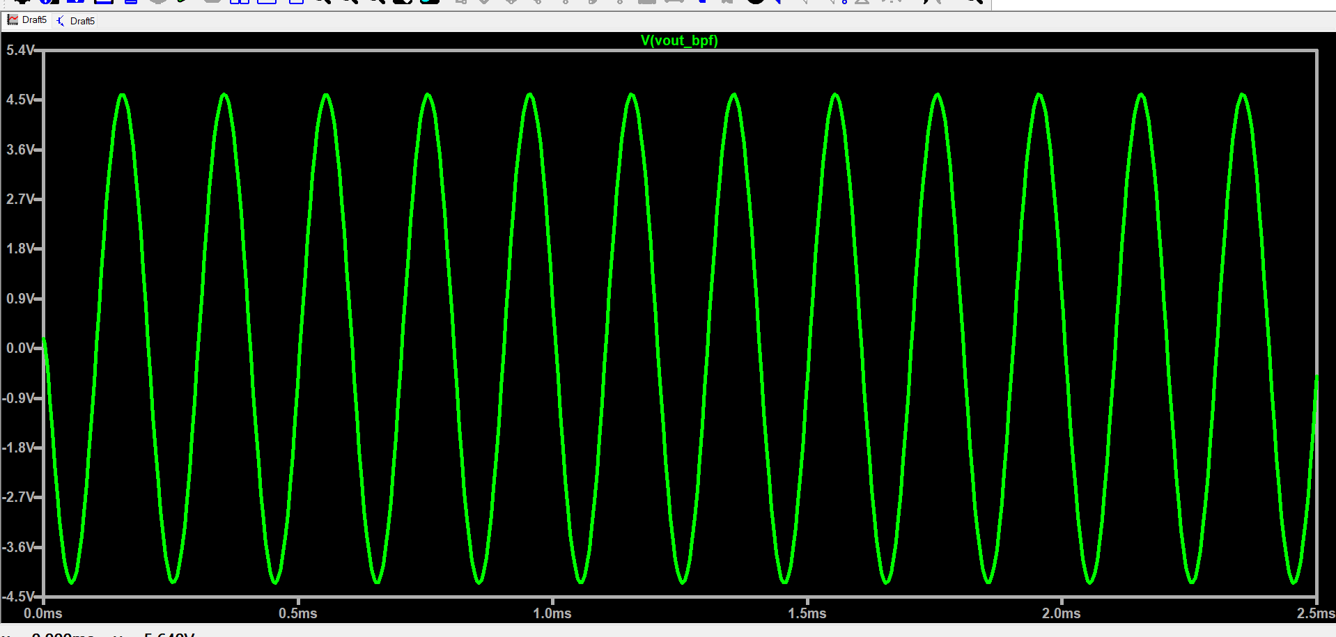
[picture p18: figure]

Figure 18: Band Pass filter Output Waveforms.

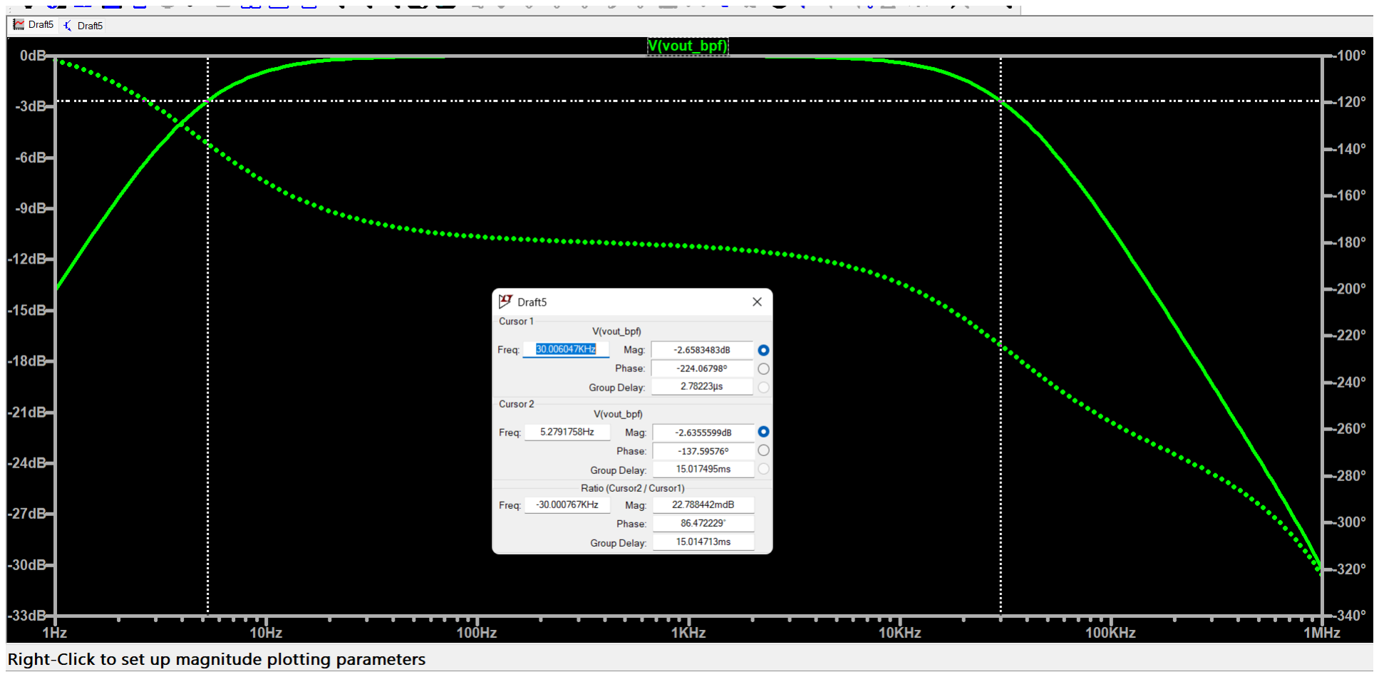
[picture p19: figure]

Figure 19: Band pass filter Bode plot Waveforms(Vin given to stage3).

### 4.5.2 Circuit Waveforms

The following waveforms were captured from the physical implementation of the CE gain stage using an oscilloscope. Deviations from the simulated results are attributed to component tolerances, parasitic capacitances, and contact resistances on the breadboard.

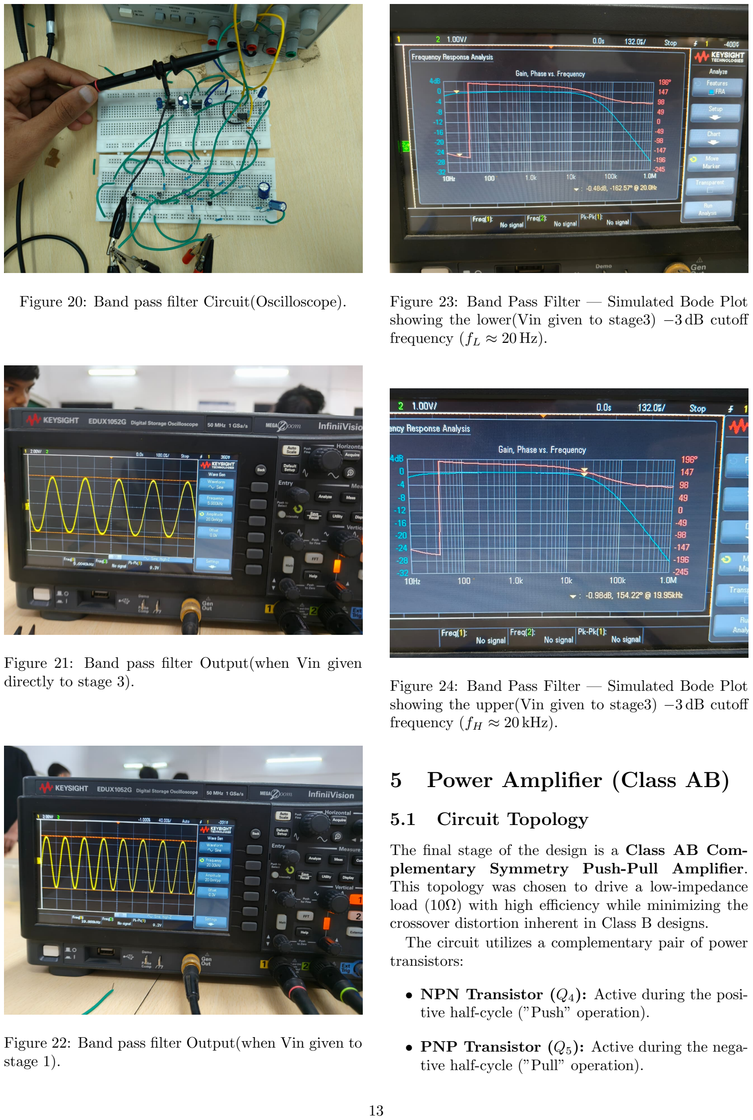
[picture p20: page 13]

Figure 20: Band pass filter Circuit(Oscilloscope).

Figure 21: Band pass filter Output(when Vin given directly to stage 3).

Figure 22: Band pass filter Output(when Vin given to stage 1).

Figure 23: Band Pass Filter — Simulated Bode Plot showing the lower(Vin given to stage3) −3 dB cutoff frequency (fL ≈ 20 Hz).

Figure 24: Band Pass Filter — Simulated Bode Plot showing the upper(Vin given to stage3) −3 dB cutoff frequency (fH ≈ 20 kHz).

## 5 Power Amplifier (Class AB)

### 5.1 Circuit Topology

The final stage of the design is a Class AB Complementary Symmetry Push-Pull Amplifier. This topology was chosen to drive a low-impedance load (10Ω) with high efficiency while minimizing the crossover distortion inherent in Class B designs.
The circuit utilizes a complementary pair of power transistors:
- NPN Transistor (Q4): Active during the positive half-cycle (”Push” operation).
- PNP Transistor (Q5): Active during the negative half-cycle (”Pull” operation).

### 5.2 Component Analysis

### 5.2.1 Diode Biasing Network (D1, D2)

A critical feature of this Class AB design is the diode biasing network. Two diodes are placed in series between the bases of Q4 and Q5.

- Purpose: They create a constant voltage drop of approximately 1.4V (0.7V + 0.7V ) between the two bases.
- Elimination of Dead Zone: This separation matches the combined Base-Emitter turn-on voltages (VBE) of the transistor pair. This ”prebiases” the transistors to be slightly ON even with zero input signal, effectively eliminating crossover distortion.
- Thermal Stability: In a physical implementation, these diodes provide thermal compensation. As temperature rises, the diode voltage drop decreases, automatically lowering the bias current to prevent thermal runaway.

### 5.2.2 Biasing Resistors (R11, R12)

These resistors set the quiescent current flowing through the diodes.
- Design Calculation: From DC analysis, assuming a diode drop of ≈ 0.65V and supply rails of ±5V . For a test resistance of 500Ω:

I =

5 − 0.65
500

=

4.35
500
= 8.7 mA | (102)

To optimize power consumption while maintaining stability, we selected R = 1kΩ, which halves the current:

Ibias =

8.7
2
= 4.35 mA | (103)
- Simulation Finding: Initially, 100kΩ resistors were used, which caused severe clipping (square wave output) due to ”current starvation”—the resistors could not supply enough base current to drive the transistors into saturation.
- Correction: Lowering these values to approximately 700Ω − 1kΩ provided sufficient base drive to maintain a clean sinusoidal output for the 10Ω load.

### 5.2.3 Coupling Capacitors (C6, C7)

The capacitors block DC bias voltage from the previous stage while allowing the AC signal to pass.

- High-Pass Action: Together with the input impedance (R ≈ 1kΩ), they form a High-Pass Filter (HPF) as the +5V / -5V sources act as virtual ground and we are taking the output and input around the capacitor.
- Frequency Calculation: We selected C = 100µF. The cutoff frequency fc is calculated as:

fc =

1 2πRC = | 1
2π(10³)(100 × 10⁻⁶)
| (104)

fc =

10
2π

=

5
π
≈ 1.59 Hz | (105)

Since 5
π < 20 Hz (the lower limit of human hearing), this capacitor value ensures that the entire audio spectrum is passed without attenuation.
- Phase Split: The input signal is applied to both bases simultaneously. Since the DC potentials at the bases are different (separated by 1.4V ), the capacitors allow the AC signal to ”ride” on top of these distinct DC bias levels.

### 5.3 Conduction Angle Analysis

A key parameter defining the operation of this power amplifier is the conduction angle (θ), which represents the portion of the 360◦
signal cycle during which
a transistor remains in its active (conducting) state.
- Class B Baseline: In a standard Class B amplifier, each transistor conducts for exactly half the cycle (θ = 180◦
). This results in a ”dead zone” at the zero-crossing point where neither transistor is active, causing crossover distortion.
- Class AB Optimization: By introducing the diode biasing network (D1, D2), we apply a small forward voltage to the transistor bases. This extends the conduction angle to be slightly greater than 180◦

(180◦ < θ ≪ 360◦
).

Relevance to Design: This extended angle creates a small ”overlap” region where both Q4 and Q5 conduct simultaneously for a brief moment around the zero-crossing. This overlap ensures a smooth handover of current between the push and pull stages, effectively eliminating crossover distortion without incurring the high power penalty of a Class A amplifier (which conducts for the full 360◦
).

### 5.4 Circuit Operation

### 5.4.1 Detailed Cycle-by-Cycle Analysis

The complementary nature of the NPN and PNP transistors allows the circuit to handle alternating current by switching conduction duties. The operation is defined by the following two states:

### 1. Positive Half-Cycle (Vin > 0)

- State: The NPN transistor (Q4) is forward-biased and turns ON. The PNP transistor (Q5) becomes reverse-biased and turns OFF.

- KVL Analysis: Applying Kirchhoff’s Voltage Law to the base-emitter loop of Q4:
Vin + VD1 − VBE4 − Vout = 0 | (106)

Since VD1 ≈ VBE4 ≈ 0.7V , these terms cancel out, resulting in:

Vout ≈ Vin | (107)

### 2. Negative Half-Cycle (Vin < 0)

- State: The PNP transistor (Q5) is forward-biased and turns ON. The NPN transistor (Q4) turns OFF.
- KVL Analysis: Applying KVL to the base-emitter loop of Q5:
Vin − VD2 + VEB5 − Vout = 0 | (108)

Again, assuming matching VD2 ≈ VEB5:

Vout ≈ Vin | (109)

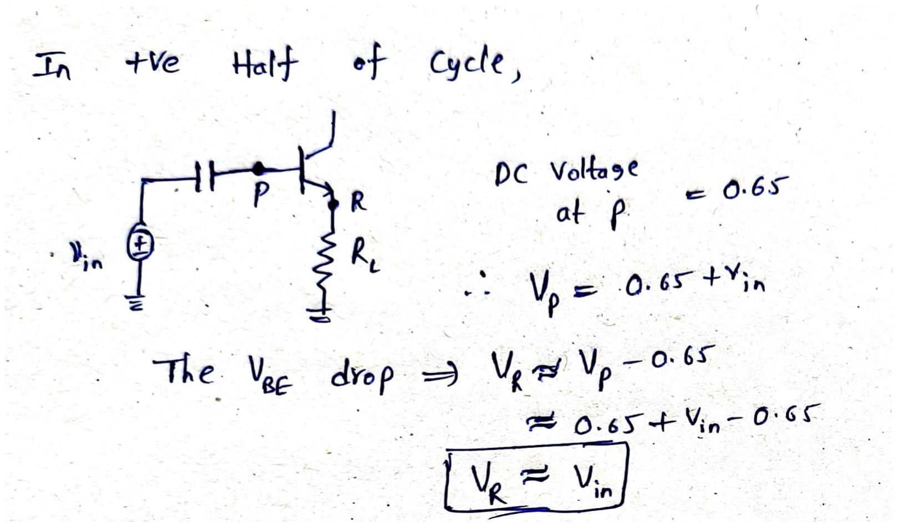
[picture p21: figure]

Figure 25: LTspice Schematic of the Class AB Stage with Diode Biasing.

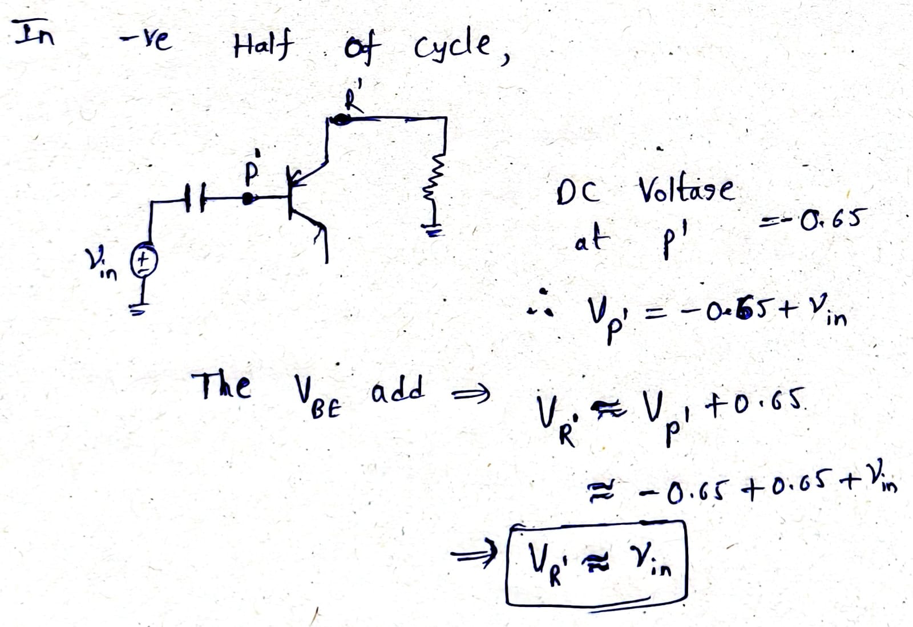
[picture p22: figure]

Figure 26: LTspice Schematic of the Class AB Stage with Diode Biasing.

Input | NPN (Q4) | PNP (Q5) | Action
Vin > 0 | ON | OFF | Pushing current
Vin < 0 | OFF | ON | Pulling current

Table 2: Transistor Switching Logic

### 5.4.2 Voltage Follower Configuration

The amplifier is configured as an Emitter Follower (Common Collector).

- Voltage Gain (Av): Slightly less than unity (≈ 1). This explains why the output amplitude (8.44V ) is slightly lower than the input peak (8.63V ) due to VBE losses.
- Current Gain (Ai): Very high. This allows the circuit to act as a buffer, converting the highimpedance voltage signal from previous stages into a high-current signal capable of driving the speaker.

### 5.5 Design Challenges and Solutions

### 5.5.1 High Frequency Slew Rate Limiting

At higher frequencies (20kHz), the output waveform appeared triangular (ramp-like) rather than sinusoidal. This was identified as Slew Rate Limiting.
- Cause: The internal junction capacitances of the transistors and the compensation capacitance of the driving Op-Amp could not charge/discharge fast enough to track the steep slope of a high-frequency signal.
- Solution: Decreasing the biasing resistors increases the available charging current, improving the bandwidth.

### 5.5.2 The ”Current Source” Paradox

A theoretical contradiction was analyzed regarding current drive capability. The DC analysis suggested the bias resistors (R11/R12) could only supply ≈ 4.35mA, while the peak load requirement calculated was 10mA (by assuming the beta of tip bjts to be around 50 and vmax is 5V).
Resolution: The analysis confirmed that while the DC bias resistors set the idle point, the AC input signal source (coupled via capacitors) provides the dynamic peak current required to drive the transistor bases during high-load conditions. The signal source itself acts as the current reservoir for these peaks, bypassing the limitation of the DC bias resistors.
5.6 | Design Rationale: | Selection of
Class AB Topology

The choice of a Class AB configuration for the power stage was driven by a specific set of trade-offs between linearity (sound quality) and power efficiency.

### 5.6.1 Comparison with Class A

While a Class A amplifier offers superior linearity by keeping transistors conducting 100% of the time (360◦
), it is highly inefficient (typically 15% - 25%). For our target application, the excessive heat dissipation and continuous power consumption of a Class A design were deemed impractical.

### 5.6.2 Comparison with Class B

A Class B amplifier improves efficiency (up to 78.5%) by switching transistors off for half the cycle. However, this creates a ”dead zone” at the zero-crossing point where neither transistor conducts, resulting in audible Crossover Distortion.

- Observation: In preliminary simulations without bias diodes (Class B mode), the output waveform exhibited distinct ”flat spots” at voltage crossings, confirming the unsuitability of pure Class B for high-fidelity audio.

### 5.6.3 The Class AB Compromise

Class AB was selected as the optimal compromise. By introducing a small bias voltage (≈ 1.4V via diodes), we ensure a conduction angle slightly greater than 180◦
. This eliminates the crossover distortion of Class B while maintaining an efficiency significantly higher than Class A (typically 50% - 60%), making it the industry standard for audio applications.

### 5.7 Power Output Calculation

The RMS power delivered to the load can be determined from the output voltage waveform. Based on the transient analysis, the amplifier produces a peak output voltage (Vp) of approximately 4.0 V across the 10 Ω load resistor (RL).
The RMS power output is calculated using the formula:

Pout(rms) =

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
(110)

Substituting the measured simulation values (Vp = 4.0 V, RL = 10 Ω):

Pout(rms) =

(4.0)²
2 × 10

=

16
20

= 0.8Watts (111)

This confirms that the Class AB stage successfully acts as a power amplifier, delivering substantial real power (800 mW) to the low-impedance speaker load.

### 5.8 Unity Voltage Gain (No Additional

Voltage Gain)

The Class AB power amplifier is configured as a Push-Pull Emitter Follower (Common Collector). A fundamental characteristic of this topology is that it provides massive current gain to drive the load, but adds no additional voltage gain to the system.
From the simulation parameters shown previously:
- Input Voltage (Vin): 8.0 Vpp (4.0 Vpeak)
- Output Voltage (Vout): ≈ 8.0 Vpp (≈ 4.0 Vpeak)

Calculating the voltage gain (Av):

Av =

Vout

Vin

≈

4.0 V
4.0 V
= 1 | (112)

This confirms the stage acts purely as a unity-gain voltage buffer (Av ≈ 1 or 0 dB). The output voltage closely tracks the input voltage, meaning the overall voltage amplitude of the audio signal is entirely determined by the preceding pre-amplifier and CE gain stages.

### 5.9 Simulation and Experimental Re-

sults

### 5.9.1 LTspice Simulation

The circuit was simulated using LTspice XVII to verify the operating point and frequency response.

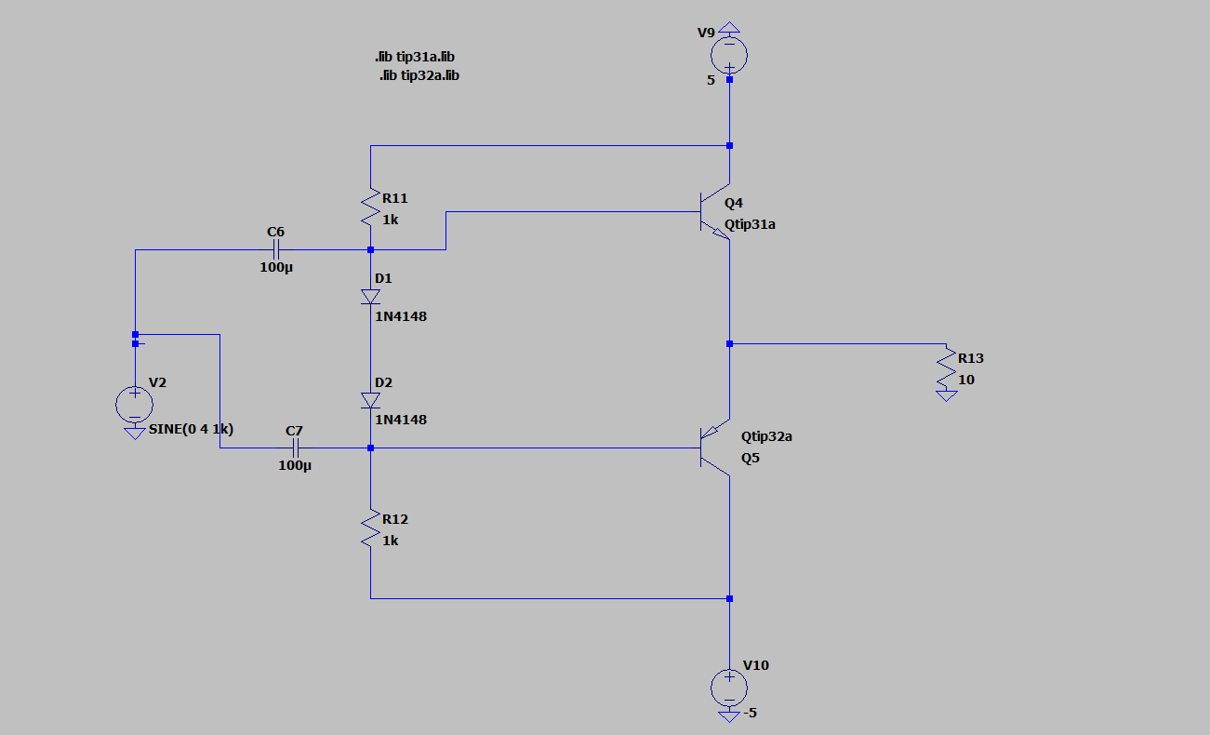
[picture p23: figure]

Figure 27: LTspice Schematic of the Class AB Stage with Diode Biasing.

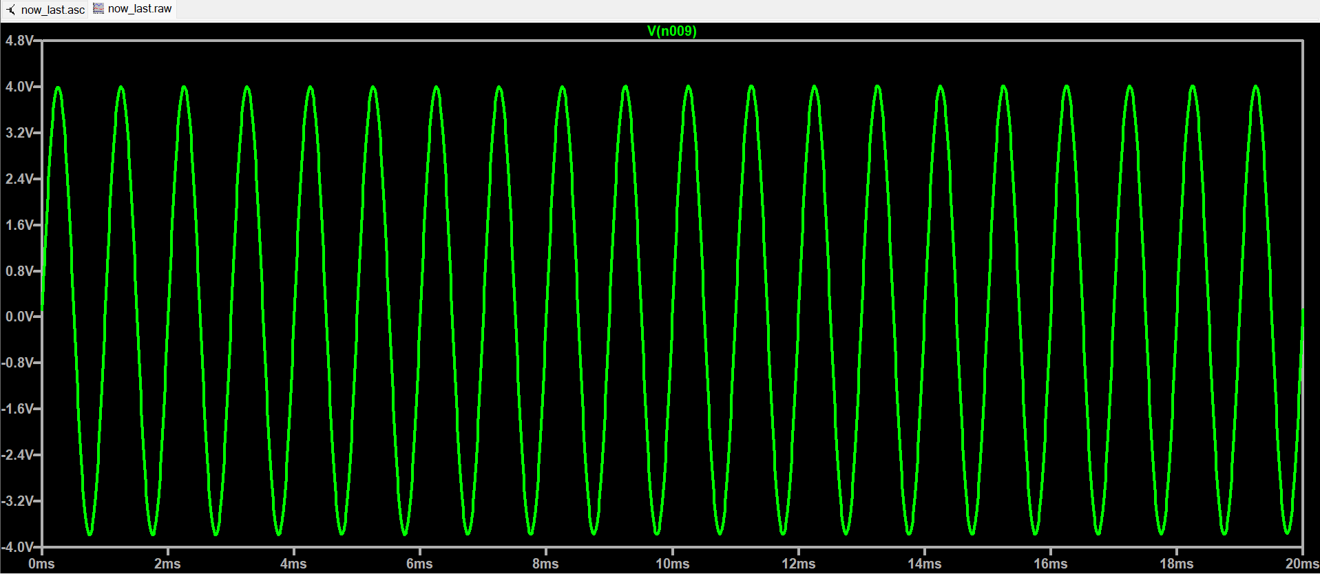
[picture p24: figure]

Figure 28: LTspice Schematic of the Class AB Stage with input of 8Vpp.

### 5.10 Hardware Implementation

The design was implemented on a breadboard using TIP31 (NPN) and TIP32 (PNP) power transistors.

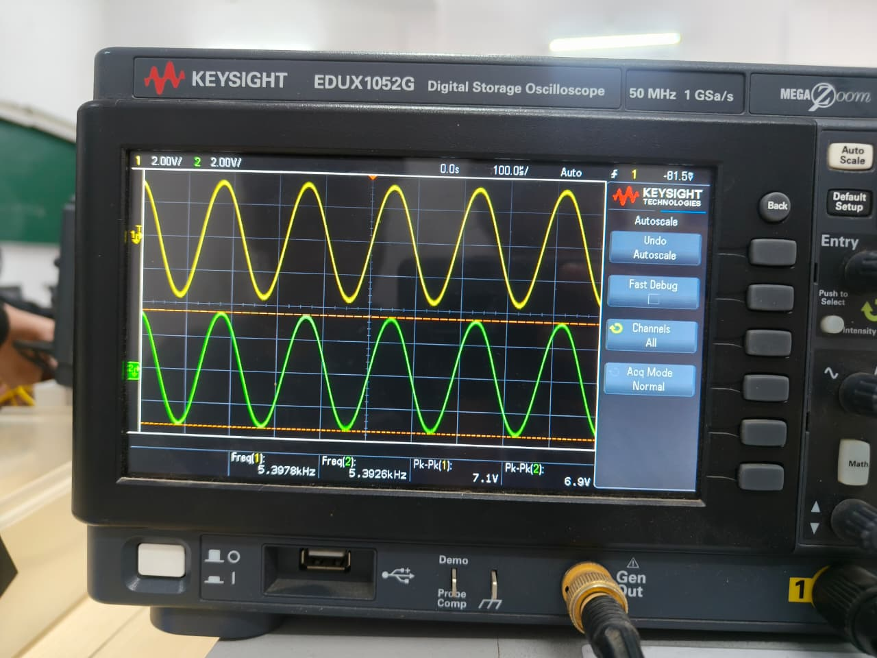
[picture p25: figure]

Figure 29: Experimental output of the Class AB Stage with input of 8Vpp.

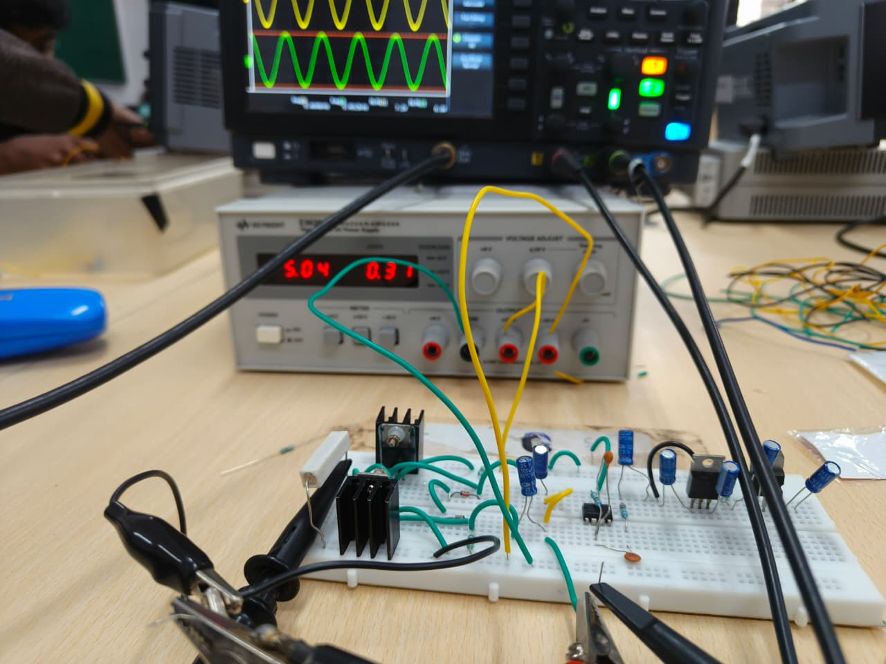
[picture p26: figure]

Figure 30: Experimental setup for the Class AB Stage

## 6 Voltage Regulator

A voltage regulator is used to convert the dual ±12 V supply (provided by the transformer and rectifier stage) down to the stable ±5 V required by the circuit. Two fixed linear voltage regulators are employed — one for each rail:

- LM7805 — Positive voltage regulator: converts +12 V to a stable +5 V output.
- LM7905 — Negative voltage regulator: converts −12 V to a stable −5 V output.

Linear regulators were chosen over switching regulators for this application due to their simplicity, low output noise, and absence of switching artefacts — all of which are critical in an audio amplifier circuit where signal integrity must be maintained.

### 6.0.1 LM7805 — Positive Voltage Regulator

The LM7805 is a three-terminal fixed positive linear voltage regulator capable of supplying up to 1 A of output current with an output voltage of +5 V. It requires an input voltage of at least 7 V to regulate correctly, giving a dropout voltage of approximately 2 V. With a +12 V input, the device operates well within its specified range.

Pin Configuration The LM7805 is supplied in a TO-220 package with three pins:

1. Pin 1 — Input (IN): Connects to the positive unregulated DC supply (+12 V).
2. Pin 2 — Ground (GND): Connected to the circuit common ground.
3. Pin 3 — Output (OUT): Provides the regulated +5 V DC output.

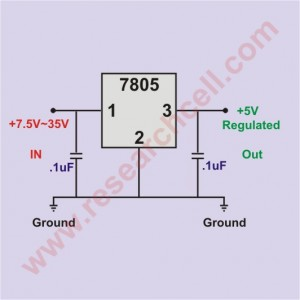
[picture p27: figure]

Figure 31: LM7805 Positive Voltage Regulator — Pin Diagram (TO-220 Package).

### 6.0.2 LM7905 — Negative Voltage Regulator

The LM7905 is the negative-rail counterpart to the LM7805, providing a fixed regulated output of −5 V from a −12 V input. It is also a three-terminal device in the TO-220 package, but its pin ordering differs from the LM7805 .

Pin Configuration The LM7905 pin assignments are as follows:

1. Pin 1 — Ground (GND): Connected to the circuit common ground.
2. Pin 2 — Input (IN): Connects to the negative unregulated DC supply (−12 V).

3. Pin 3 — Output (OUT): Provides the regulated −5 V DC output.

Note that the pin ordering of the LM7905 is not the same as the LM7805 — the Ground and Input pins are swapped.

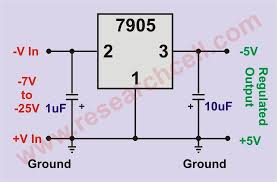
[picture p28: figure]

Figure 32: LM7905 Negative Voltage Regulator .

### 6.0.3 Voltage Regulator Final Circuit

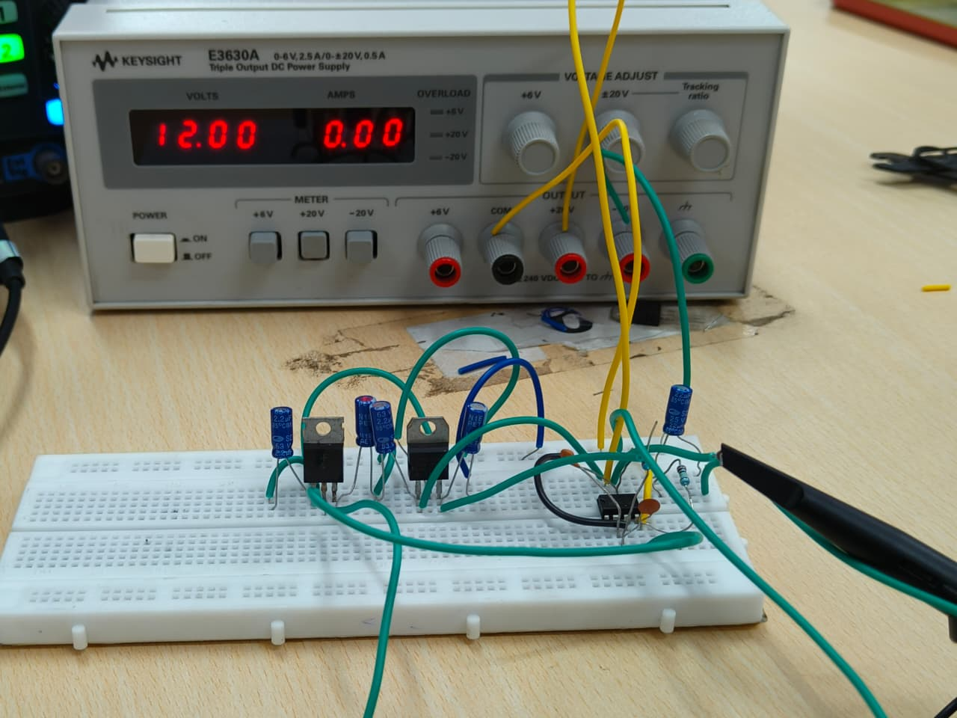
[picture p29: figure]

Figure 33: Voltage Regulator Final Circuit .

## 7 Overall Performance Analysis

### 7.1 Final Integration Performance

### 7.1.1 Overall LTspice Simulations

To validate the complete system design before physical construction, all four stages (Pre-amplifier, CE Gain Stage, Band-Pass Filter, and Class AB Power Amplifier) were cascaded in LTspice. A comprehensive transient analysis was performed using a 10 mVpk audio-band sinusoidal input.
The simulation confirms that the small signal is successfully amplified by the first two stages, filtered to remove out-of-band frequencies, and finally buffered by the Class AB stage. The power stage provides the necessary current to drive the 10 Ω load without introducing voltage clipping or crossover distortion.

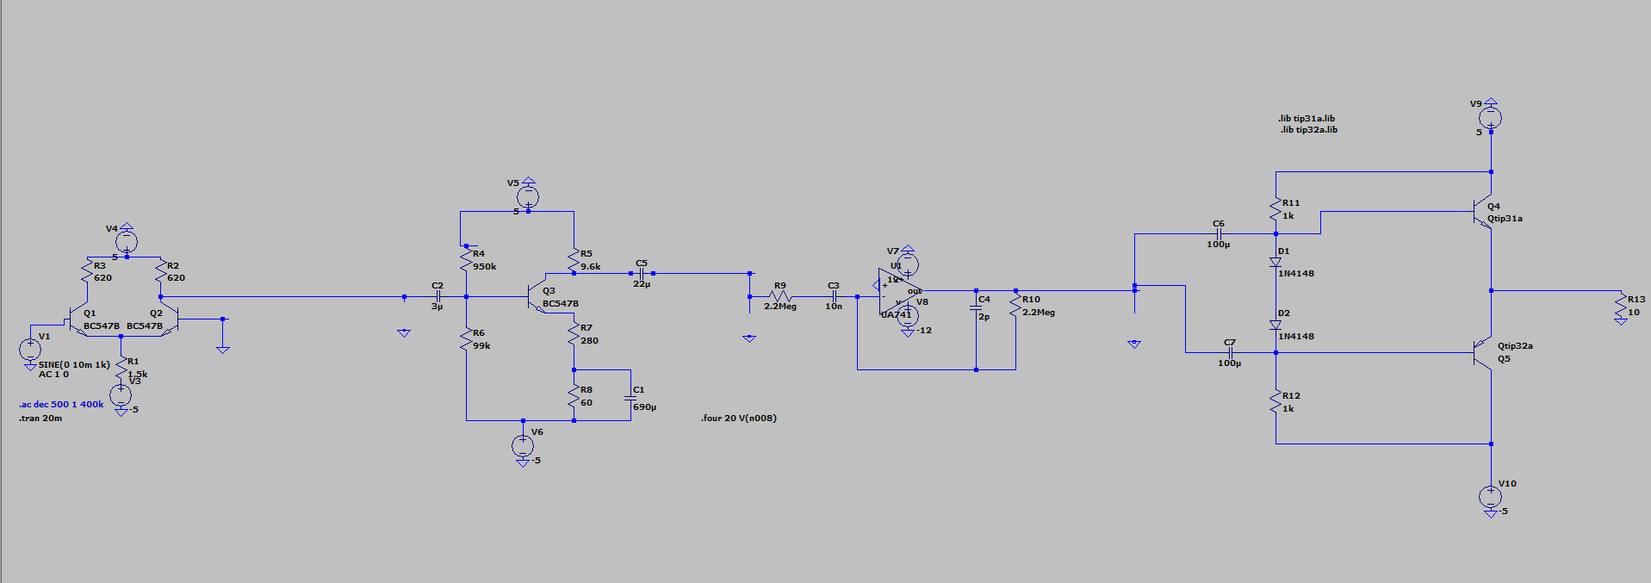
[picture p30: figure]

Figure 34: LTspice Schematic of the fully integrated multi-stage audio amplifier.

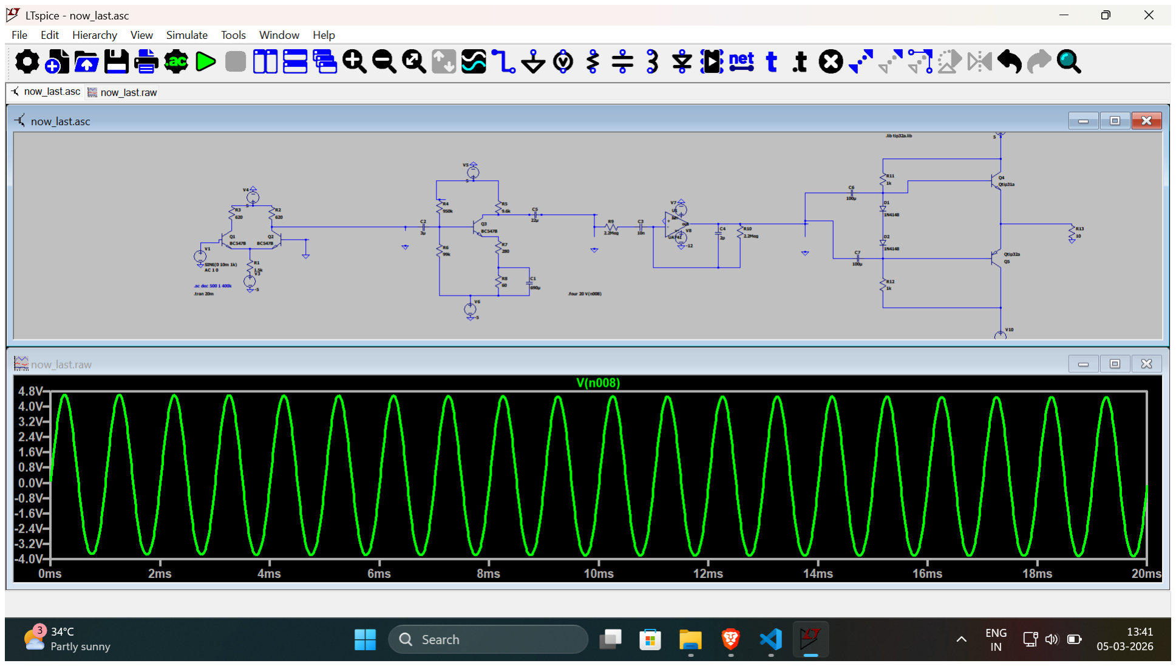
[picture p31: figure]

Figure 35: Overall System Transient Analysis: Small-signal input vs. final amplified output across the 10 Ω load.

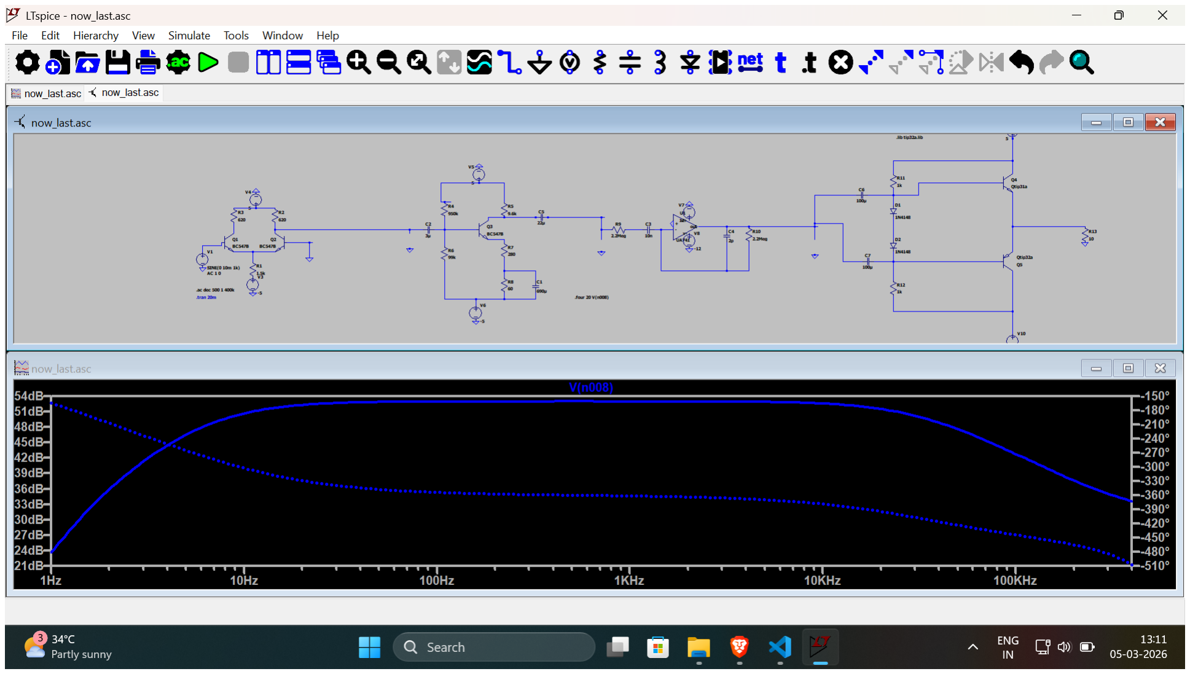
[picture p32: figure]

Figure 36: Overall System bode plot

### 7.1.2 Overall Hardware Implementation

Following successful simulation, the complete multi-stage amplifier was constructed on a breadboard. Discrete components were used throughout the build, including matched BJTs for the differential pair, a BC547 transistor for the gain stage, and the TIP31/TIP32 complementary pair for the power stage. The physical system was tested using a function generator to inject a small-signal sine wave, while an oscilloscope was used to monitor the signal progression through intermediate stages and at the final load. The experimental results closely tracked the simulated behavior, demonstrating successful high-fidelity audio amplification, adequate power delivery to the load, and the practical elimination of Class B crossover distortion.

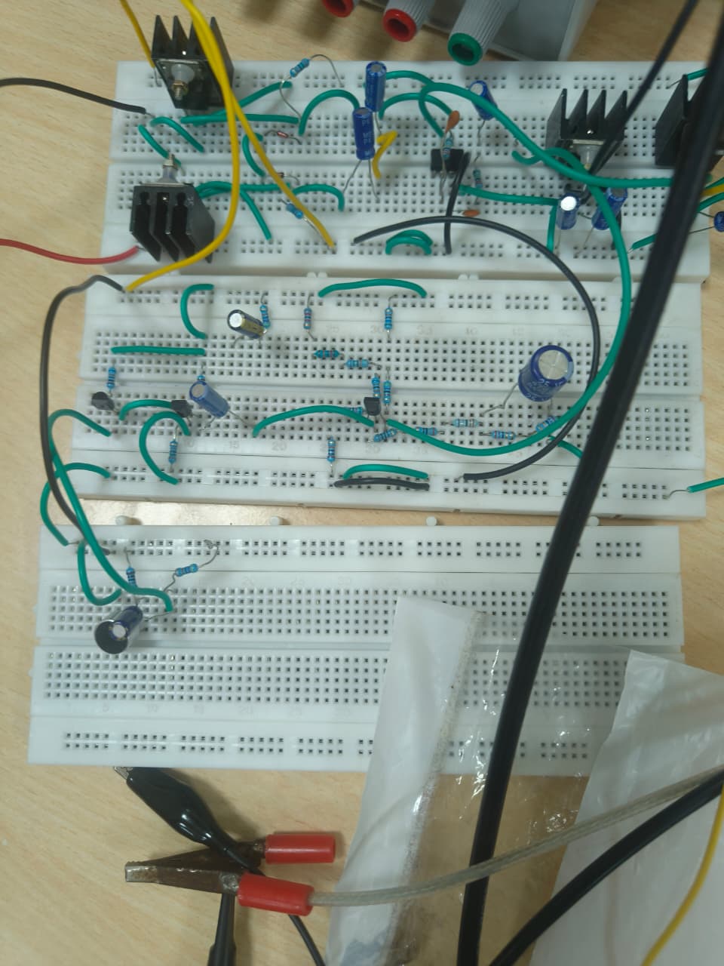
[picture p33: figure]

Figure 37: Experimental breadboard setup of the fully integrated multi-stage amplifier.

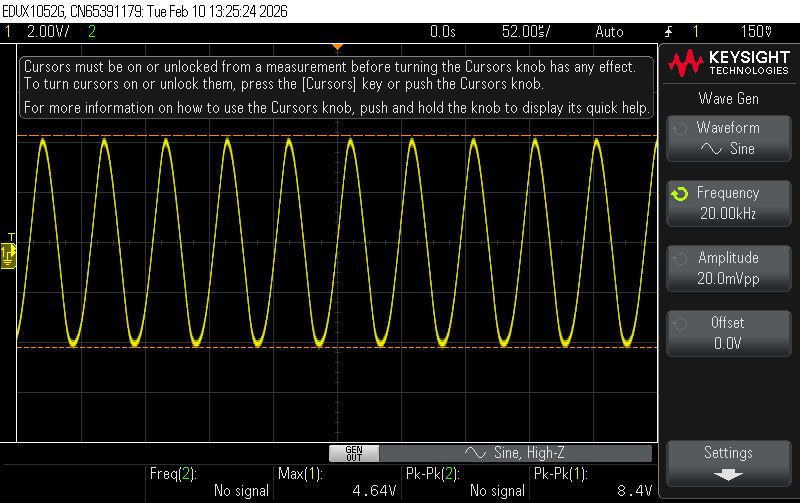
[picture p34: figure]

Figure 38: Oscilloscope capture showing the final amplified output waveform driving the physical load.

### 7.2 Total Harmonic Distortion (THD)

Analysis

To evaluate the linearity and fidelity of the final power amplifier, a Total Harmonic Distortion (THD) analysis was performed, based on FFT analyses in LTspice. We derived handwritten harmonic voltage measurements for two critical test frequencies to assess performance across the audio band. THD is defined as the ratio of the root-sum-square voltage of the harmonic components to the voltage of the fundamental component:

T HD =

p
V

2
2 + V

2
3 + V

2
4 + . . .
V1

× 100% (113)

The measured harmonic magnitudes in dBV (decibel-volts) are tabulated below. These values are converted to linear voltages to compute the final THD percentages.

Harmonic | Frequency | Magnitude (dBV)
Fundamental (V1) | 3 kHz | 8.750
2nd (V2) | 6 kHz | -7.500
3rd (V3) | 9 kHz | -26.250
4th (V4) | 12 kHz | -30.000
5th (V5) | 15 kHz | -37.500

Table 3: Harmonic Magnitudes for Test 1 (3 kHz)

Harmonic | Frequency | Magnitude (dBV)
Fundamental (V1) | 20 kHz | 6.250
2nd (V2) | 40 kHz | -22.875
3rd (V3) | 60 kHz | -27.500
4th (V4) | 80 kHz | -32.500
5th (V5) | 100 kHz | -38.125

Table 4: Harmonic Magnitudes for Test 2 (20 kHz)

Our findings based on the data in Tables 3 and 4 are as follows:

- Test at moderate frequency (3 kHz): The THD was calculated to be approximately 2.2%. This confirms good linearity for typical audio signals within the amplifier’s design specifications.
- High-frequency test (20 kHz): The THD increased, measuring approximately 4.26%. This increase is expected, as non-linearities and finite slew rate limitations (Section 5.3) begin to add more harmonic components to the output.

These results demonstrate that the Class AB stage successfully mitigates crossover distortion while providing robust, high-fidelity power amplification. Figure 40 displays a representative synthetic FFT spectrum plot, illustrating the strong fundamental signal and declining harmonic power.

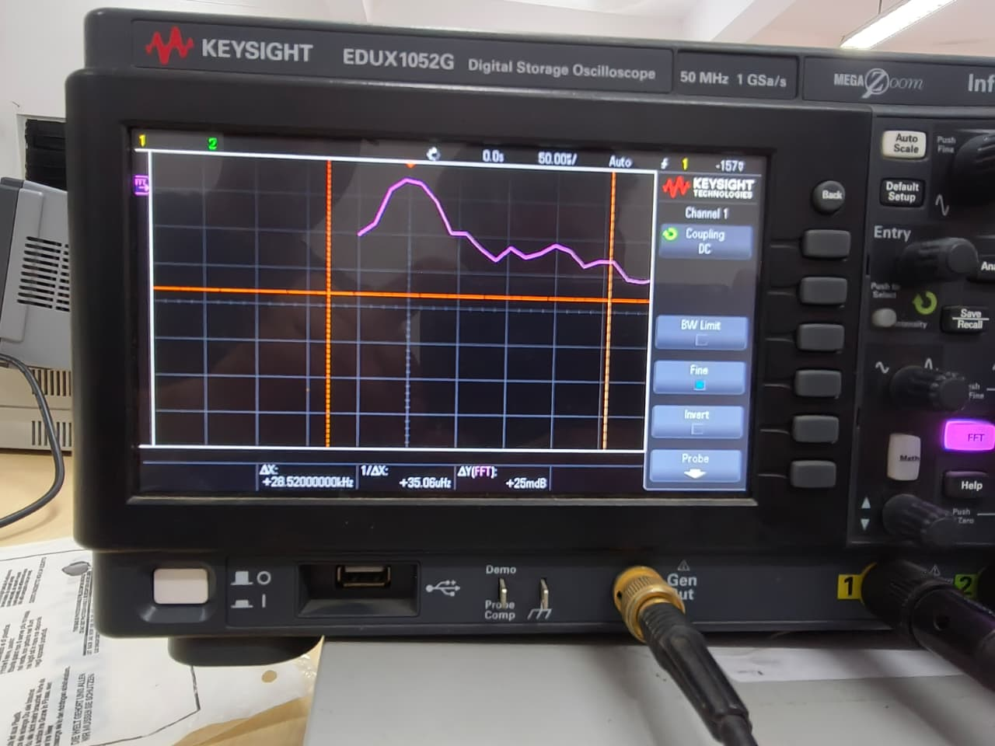
[picture p35: figure]

Figure 39: Synthetic representative FFT Spectrum plot showing fundamental and harmonic levels at 3kHz.

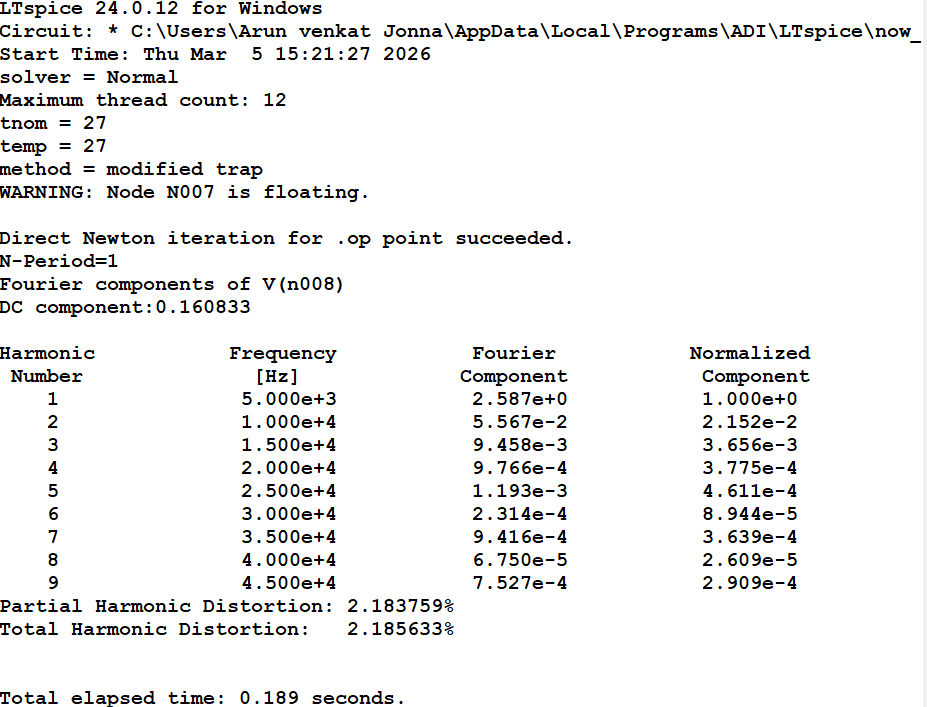
[picture p36: figure]

Figure 40: THD simulation for 5kHz.

### 7.3 Slew Rate Analysis

The slew rate (SR) defines the maximum rate of change of the amplifier’s output voltage. If the signal demands a rate of change faster than the amplifier can physically provide, the output will distort, turning a sine wave into a triangular wave (Slew Rate Limiting).

Theoretical Requirement

For a sinusoidal output voltage Vout(t) = Vp sin(2πf t), the rate of change is the derivative:

dVout
dt | = 2πfVp cos(2πf t) | (114)

The maximum rate of change occurs as the wave crosses zero (cos(2πf t) = 1). Therefore, the required Slew Rate is:

SRreq = 2πfmaxVp | (115)

For our amplifier, the highest target audio frequency is fmax = 20 kHz, and the peak output voltage observed is Vp ≈ 4.0 V. Plugging in these values:

SRreq = 2π(20×10³
)(4.0) ≈ 502, 654 V/s ≈ 0.50 V/µs (116)
This indicates that the amplifier must be capable of changing its output by at least 0.50 V every microsecond to pass a full-power 20 kHz sine wave without distortion.

Simulation result via Step Response

While the mathematical derivative defines the required slew rate for a sine wave, an amplifier’s actual Slew Rate is a large-signal, non-linear limitation dictated by the maximum internal current available to charge internal and parasitic capacitances (SR = Imax/C). Because of this physical bottleneck, Slew Rate is standardly measured not with a sine wave, but by applying a large-signal Square Wave (step input) to the amplifier. The instantaneous voltage jump forces the amplifier to its maximum slewing capability, transforming the vertical edges of the square wave into measurable voltage ramps.
To measure this, a 10 kHz pulse input was applied, and the transient response was captured. The measurement was taken along the linear ramp of the rising edge. From the LTspice cursor measurements (as shown in Figure 41):
- Voltage Change (∆V ): 3.521 V (from 0.996 V to 4.517 V)
- Time Interval (∆t): 15.483 µs

SRmeasured =

∆V
∆t

=

3.521 V
15.483 µs

≈ 0.227 V/µs (117)

Analysis & Impact on Distortion: The measured Slew Rate of 0.227 V/µs represents the absolute physical speed limit of the amplifier. This capability falls significantly short of the required 0.50 V/µs demanded by a 20 kHz full-amplitude sine wave. Because the amplifier cannot charge its internal capacitances fast enough to track the fast-moving signal, it enters severe Slew Rate Limiting. Instead of drawing a smooth sine curve, the amplifier outputs a straight diagonal line at its maximum speed, effectively chopping the sine wave into a triangular waveform. This phenomenon, known as Slew-Induced Distortion (SID), directly explains the sudden increase in Total Harmonic Distortion (THD to 4.26%) measured at 20 kHz in the previous section.

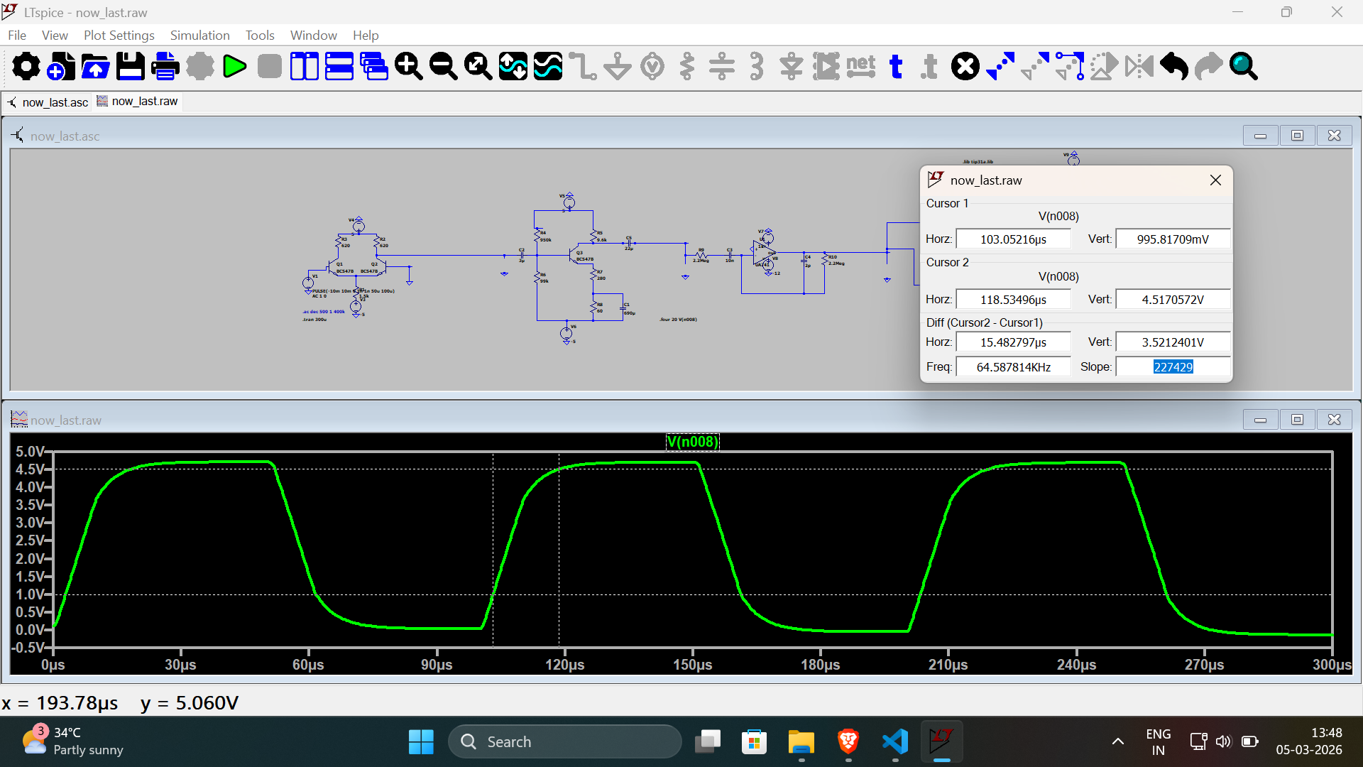
[picture p37: figure]

Figure 41: LTspice Slew Rate measurement using a square wave pulse input, showing cursor values for the ∆V /∆t calculation.

Practical Slew Rate Measurement

A square wave input was applied to the physical circuit and the transient response was captured on the oscilloscope. The slew rate was measured along the linear ramp of the rising edge:
Voltage Change (∆V ): 3.485 V (from 0.995 V to 4.48 V)
Time Interval (∆t): 14.583 µs

SRmeasured =

∆V
∆t

=

3.8901 V
16.383 µs

≈ 0.238 V/µs (118)

Comparison with Simulation: The practical slew rate of 0.237 V/µs compares closely to the simulated value of 0.227 V/µs (deviation < 5%). This minimal discrepancy is attributed to breadboard parasitic capacitances, component tolerances, and the physical UA741 op-amp’s non-ideal behaviour versus its SPICE model.

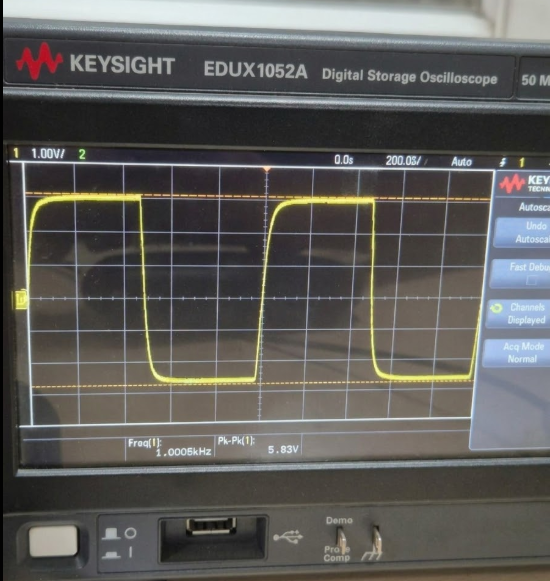
[picture p38: figure]

Figure 42: Practical Slew Rate measurement using a square wave input, showing the rising edge ramp captured on the oscilloscope.
