avj17/Audio_amplifier_design/ltspice_files/gain_stage.asc

C1: cap; 690µ
C2: cap; 3µ
C5: cap; 22µ
Q3: npn; BC547B
R4: res; 950k
R5: res; 9.6k
R6: res; 99k
R7: res; 278
R8: res; 60
R14: res; 0.001
V1: voltage; SINE(0 150m 1k)
V5: voltage; 5
V6: voltage; -5
Named nets: 0
.tran 20m
