avj17/Audio_amplifier_design/ltspice_files/now_last.asc

C1: cap; 690µ
C2: cap; 3µ
C3: cap; 0.055µ
C4: cap; .1p
C5: cap; 22µ
C6: cap; 100µ
C7: cap; 100µ
D1: diode; 1N4148
D2: diode; 1N4148
Q1: npn; BC547B
Q2: npn; BC547B
Q3: npn; BC547B
Q4: npn; Qtip31a
Q5: pnp; Qtip32a
R1: res; 1.5k
R2: res; 620
R3: res; 620
R4: res; 950k
R5: res; 9.6k
R6: res; 99k
R7: res; 280
R8: res; 60
R9: res; 2.2Meg
R10: res; 2.2Meg
R11: res; 1k
R12: res; 1k
R13: res; 10
U1: UA741
V1: voltage; SINE(0 10m 1k); AC 1 0
V2: voltage; SINE(0 4.8 1k)
V3: voltage; -5
V4: voltage; 5
V5: voltage; 5
V6: voltage; -5
V7: voltage; 12
V8: voltage; -12
V9: voltage; 5
V10: voltage; -5
Named nets: 0
.tran 20m
.lib tip31a.lib
.lib tip32a.lib
.four 20 V(n008)
.ac dec 500 1 1000k
