avj17/Audio_amplifier_design/ltspice_files/opamp_stage.asc

C3: cap; 0.015µ
C4: cap; 2p
R9: res; 2.2Meg
R10: res; 2.2Meg
U1: UA741
V1: voltage; SINE(0 4 1k)
V7: voltage; 12
V8: voltage; -12
Named nets: 0
.tran 10m
.ac dec 100 10Hz 50K
