avj17/Audio_amplifier_design/ltspice_files/power_stage.asc

C6: cap; 100µ
C7: cap; 100µ
D1: diode; 1N4148
D2: diode; 1N4148
Q4: npn; Qtip31a
Q5: pnp; Qtip32a
R11: res; 1k
R12: res; 1k
R13: res; 10
V1: voltage; SINE(0 4.5 1k)
V9: voltage; 5
V10: voltage; -5
Named nets: 0
.tran 20m
.lib tip31a.lib
.lib tip32a.lib
