avj17/Audio_amplifier_design/ltspice_files/pre_stage.asc

Q1: npn; BC547B
Q2: npn; BC547B
R1: res; 1.5k
R2: res; 620
R3: res; 620
V1: voltage; SINE(0 6.5m 1k); AC 1 0
V3: voltage; -5
V4: voltage; 5
Named nets: 0
.tran 10m
.ac dec 500 1 100k
